CwbhX/uBMS-2/images/Front rev2.PNG

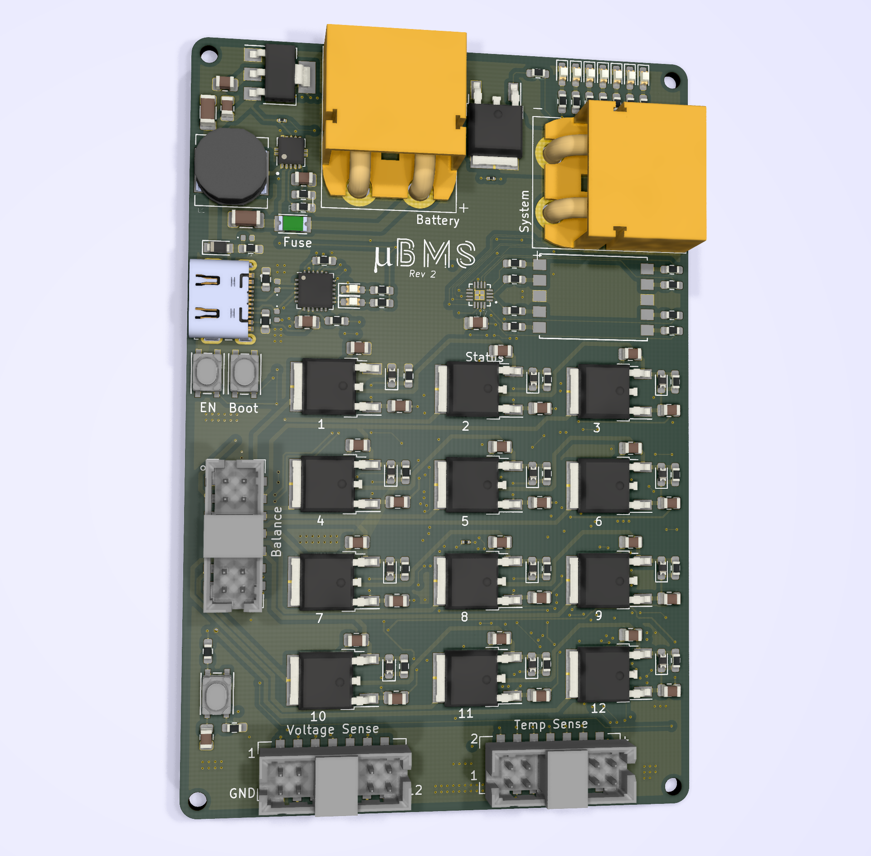
images/Front rev2.PNG
