CwbhX/uBMS-2/images/Back rev2.PNG

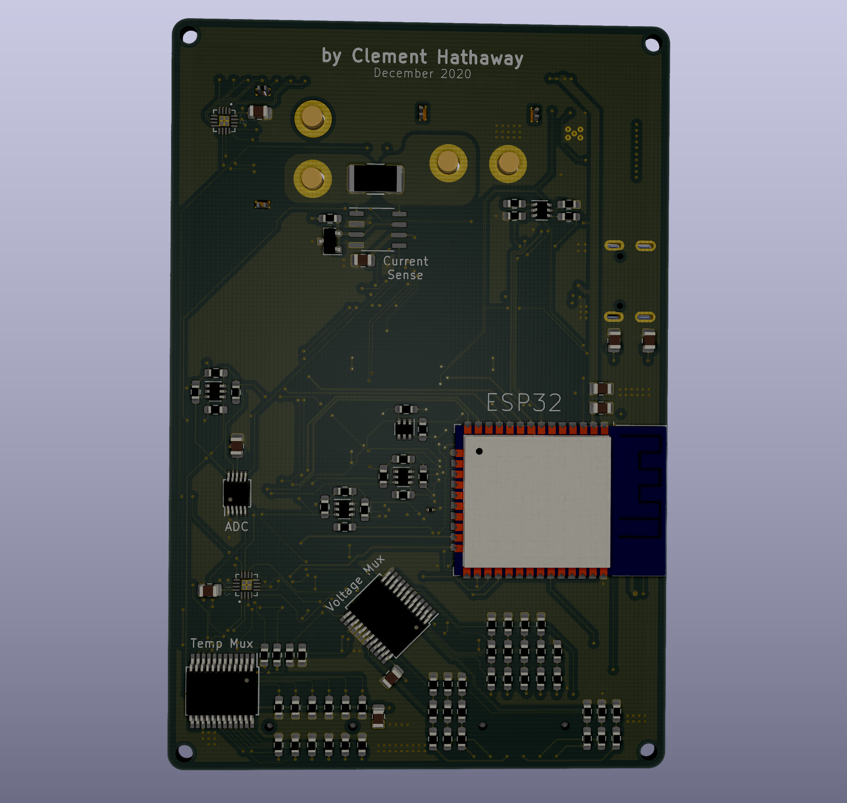
images/Back rev2.PNG
