CwbhX/uBMS-2/documents/Parts List.md

# uBMS Parts List
## Resistors
- Resetable PTC Fuse 300mA: [0ZCF0030FF2C](https://belfuse.com/resources/datasheets/circuitprotection/ds-cp-0zcf-series.pdf)

## Capacitors
- 10nF 50V X7R 0805 Caps: [C0805C103J5RAC7210](https://content.kemet.com/datasheets/KEM_C1002_X7R_SMD.pdf)
- 33nF 50V X7R 0805 Cap: [C0805C333K5RACTU](https://content.kemet.com/datasheets/KEM_C1002_X7R_SMD.pdf)
- 0.1uF 16V Y5V 0805 Caps: [C0805C104Z4VACTU](https://content.kemet.com/datasheets/KEM_C1005_Y5V_SMD.pdf)
- 1uF 16V Y5V 0805 Caps: [C0805C105Z4VACTU](https://content.kemet.com/datasheets/KEM_C1005_Y5V_SMD.pdf)
- 2.2uF 100V X7S 1206 Cin Cap: [HMK316AC7225KL-TE](https://www.yuden.co.jp/productdata/catalog/mlcc06_e.pdf)
- 10uF 10V X5R 0805 Cap: [C0805C106K8PACTU](https://content.kemet.com/datasheets/KEM_C1006_X5R_SMD.pdf)
- 47uF 6.3V X5R 1206 Cout Cap: [JMK316ABJ476MLHT](https://ds.yuden.co.jp/TYCOMPAS/ut/detail?pn=JMK316ABJ476MLHT%20%20&u=M)

## Inductors
- Buck Converter Inductor 100uH: [1267AY-101M=P3](https://www.murata.com/~/media/webrenewal/products/inductor/chip/tokoproducts/wirewoundferritetypeforpl/m_dg8040c.ashx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)

## Diodes
- USB-C Power Input 1A Schottky: [RB162VAM-20TR](https://d1d2qsbl8m0m72.cloudfront.net/en/products/databook/datasheet/discrete/diode/schottky_barrier/rb162vam-20tr-e.pdf)
- USB TVS Protection Diodes: [TPD1E10B06QDPYRQ1](https://www.ti.com/lit/ds/symlink/tpd1e10b06-q1.pdf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)

## Transistors
- 

## Integrated Circuits
- High Voltage Buck Converter 500mA: [LM5166XDRCR](https://www.ti.com/lit/ds/symlink/lm5166.pdf?HQS=TI-null-null-digikeymode-df-pf-null-wwe&ts=1606370714793)
- USB to UART Adapter: [CP2102N-A02-GQFN24](https://www.silabs.com/documents/public/data-sheets/cp2102n-datasheet.pdf)

## Connectors
- Male SMD Batt & Power connector: [XT60PW-M20](https://www.tme.eu/Document/9b8d0c5eb7094295f3d3112c214d3ade/XT60PW%20SPEC.pdf)
- Female USB-C (USB 2.0) Connector: [DX07S016JA1R1500](https://www.jae.com/direct/topics/topics_file_download/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)

## Indicators
- Red UART RX LED: [150060VS55040](https://www.we-online.de/web/en/index.php/download/media/07_electronic_components/download_center_1/application_notes_berichte/ano002_leds___the_future_of_horticultu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)
- Green UART TX LED: [150060SS55040](https://www.we-online.de/web/en/index.php/download/media/07_electronic_components/download_center_1/application_notes_berichte/ano002_leds___the_future_of_horticultu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)
- Yellow LED: [150060YS55040](https://www.we-online.de/web/en/index.php/download/media/07_electronic_components/download_center_1/application_notes_berichte/ano002_leds___the_future_of_horticultu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)
