CwbhX/uBMS-2/3D Models/PLCC6-LED.step

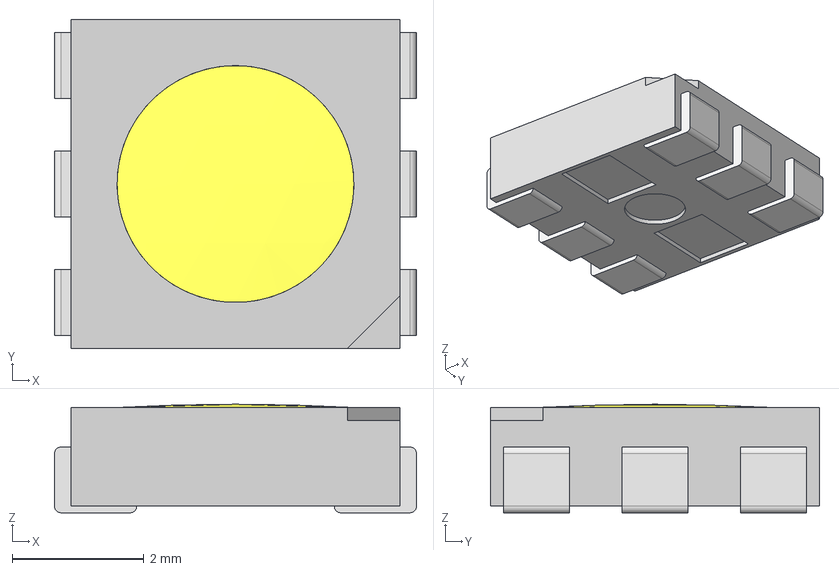
[picture p3: CAD file, 2020-08-05]
3D Models/PLCC6-LED.step
5.50 x 5.00 x 1.65 mm
