CwbhX/uBMS-2/uBMS-2.step

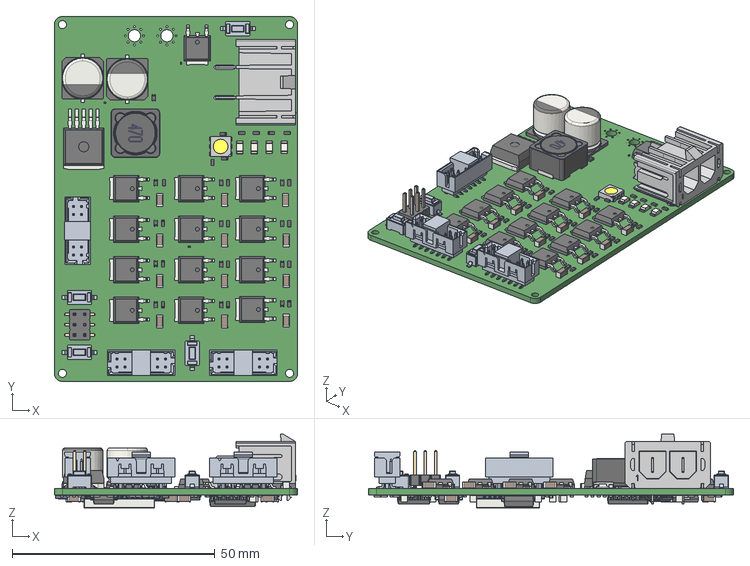
[picture p4: CAD file, 2020-08-12]
uBMS-2.step
60.0 x 90.0 x 18.2 mm
