CwbhX/uBMS-2/3D Models/RES2512.stp

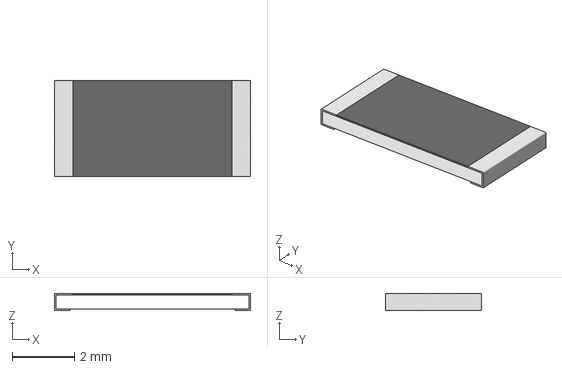
[picture p5: CAD file, 2020-08-05]
3D Models/RES2512.stp
6.30 x 3.10 x 0.55 mm
