CwbhX/uBMS-2/3D Models/SO8 Narrow 3.9mm.step

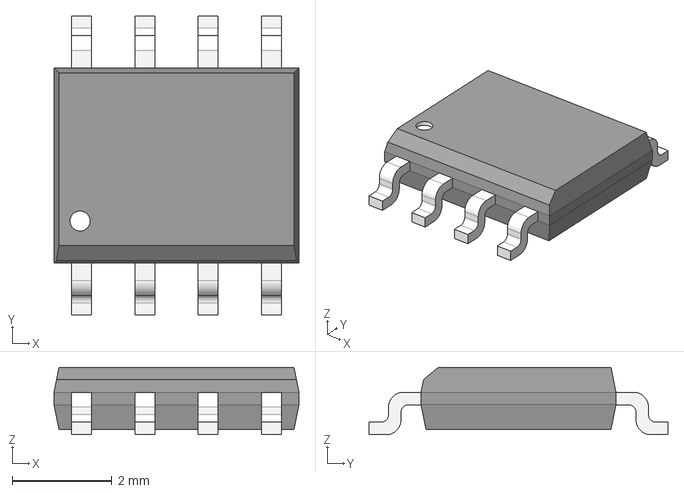
[picture p6: CAD file, 2020-08-05]
3D Models/SO8 Narrow 3.9mm.step
4.90 x 5.98 x 1.35 mm
