CwbhX/uBMS-2/3D Models/Connector_1720430202.step

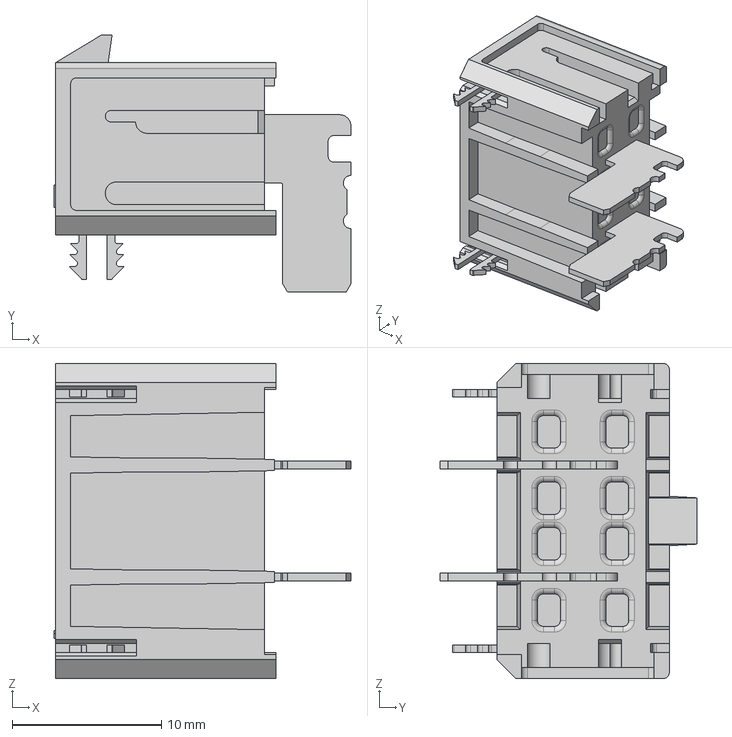
[picture p7: CAD file, 2020-08-05]
3D Models/Connector_1720430202.step
19.9 x 17.2 x 21.1 mm
