CwbhX/uBMS-2/3D Models/DR125 series.stp

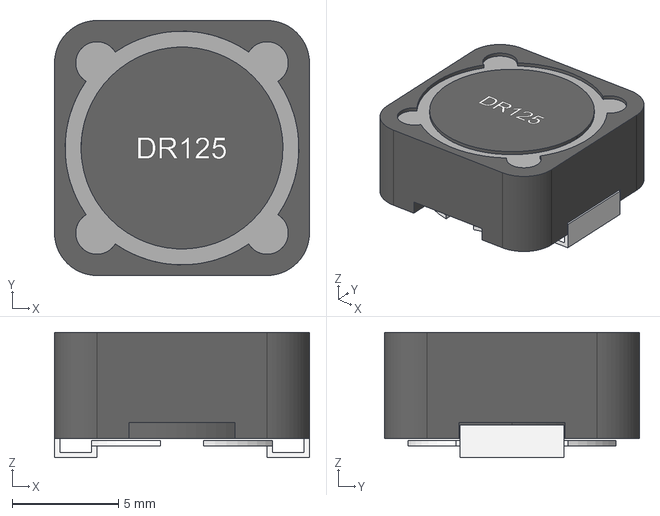
[picture p8: CAD file, 2020-08-05]
3D Models/DR125 series.stp
12.0 x 12.0 x 5.90 mm
