CwbhX/uBMS-2/3D Models/CDRH127_470M.step

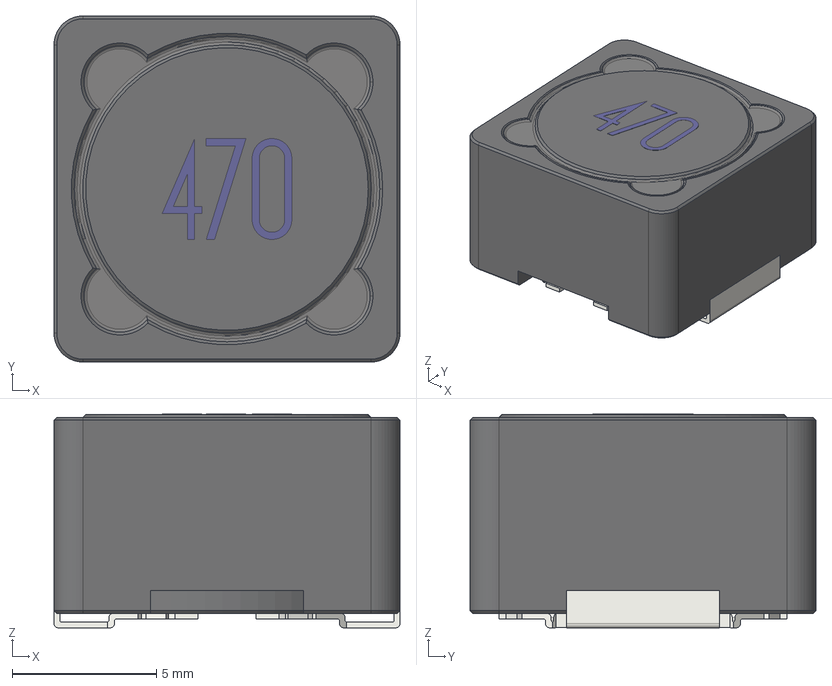
[picture p9: CAD file, 2020-08-05]
3D Models/CDRH127_470M.step
12.0 x 12.0 x 7.41 mm
