CwbhX/uBMS-2/3D Models/PTS636SM43SMTRLFS.stp

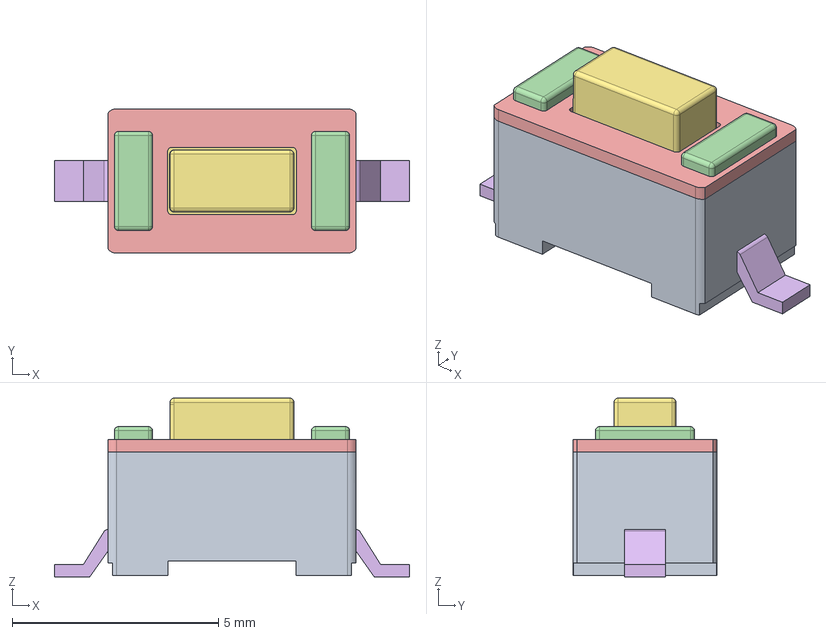
[picture p10: CAD file, 2020-08-05]
3D Models/PTS636SM43SMTRLFS.stp
8.60 x 3.50 x 4.33 mm
