CwbhX/uBMS-2/3D Models/S2B-PH-SM4-TB(LF)(SN)--3DModel-STEP-56544.STEP

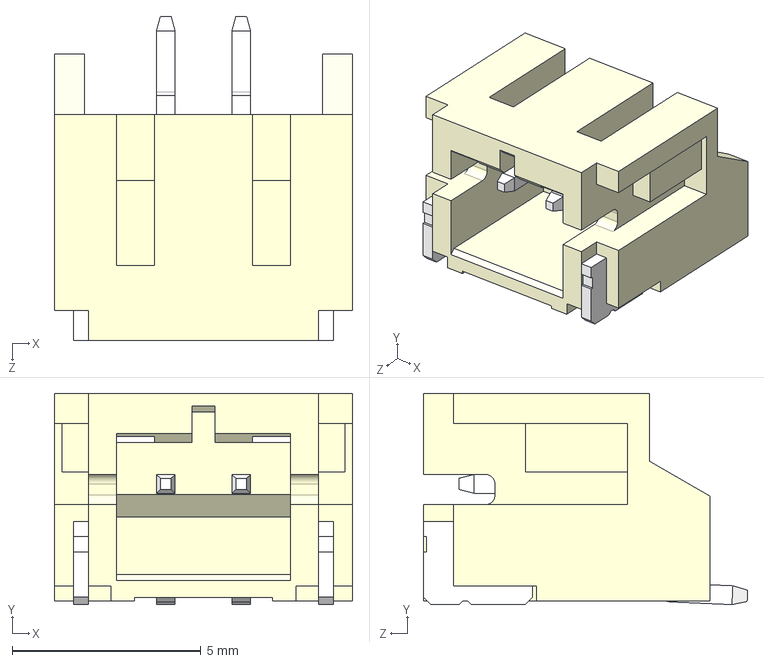
[picture p11: CAD file, 2020-08-03]
3D Models/S2B-PH-SM4-TB(LF)(SN)--3DModel-STEP-56544.STEP
7.90 x 5.60 x 8.60 mm
