CwbhX/uBMS-2/3D Models/878325623.stp

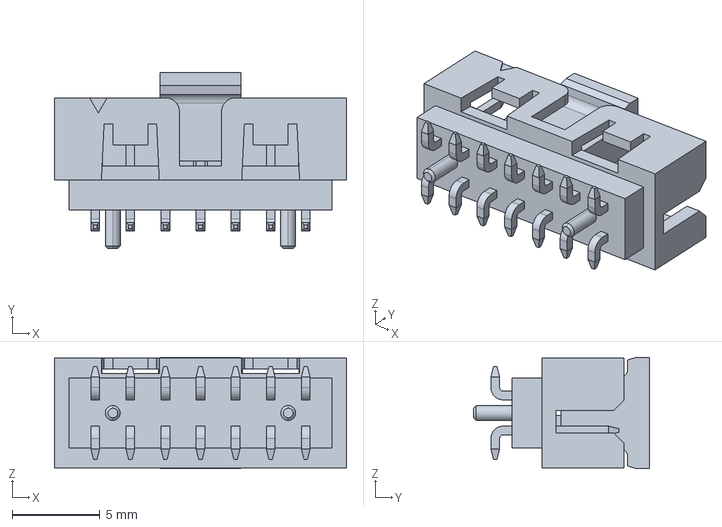
[picture p12: CAD file, 2020-08-05]
3D Models/878325623.stp
16.6 x 10.0 x 6.35 mm
