CwbhX/uBMS-2/(list of files, cad)

Other CAD files:
3D Models/1720430202.stp
