CwbhX/uBMS-2/PDFs/uBMS-2.pdf

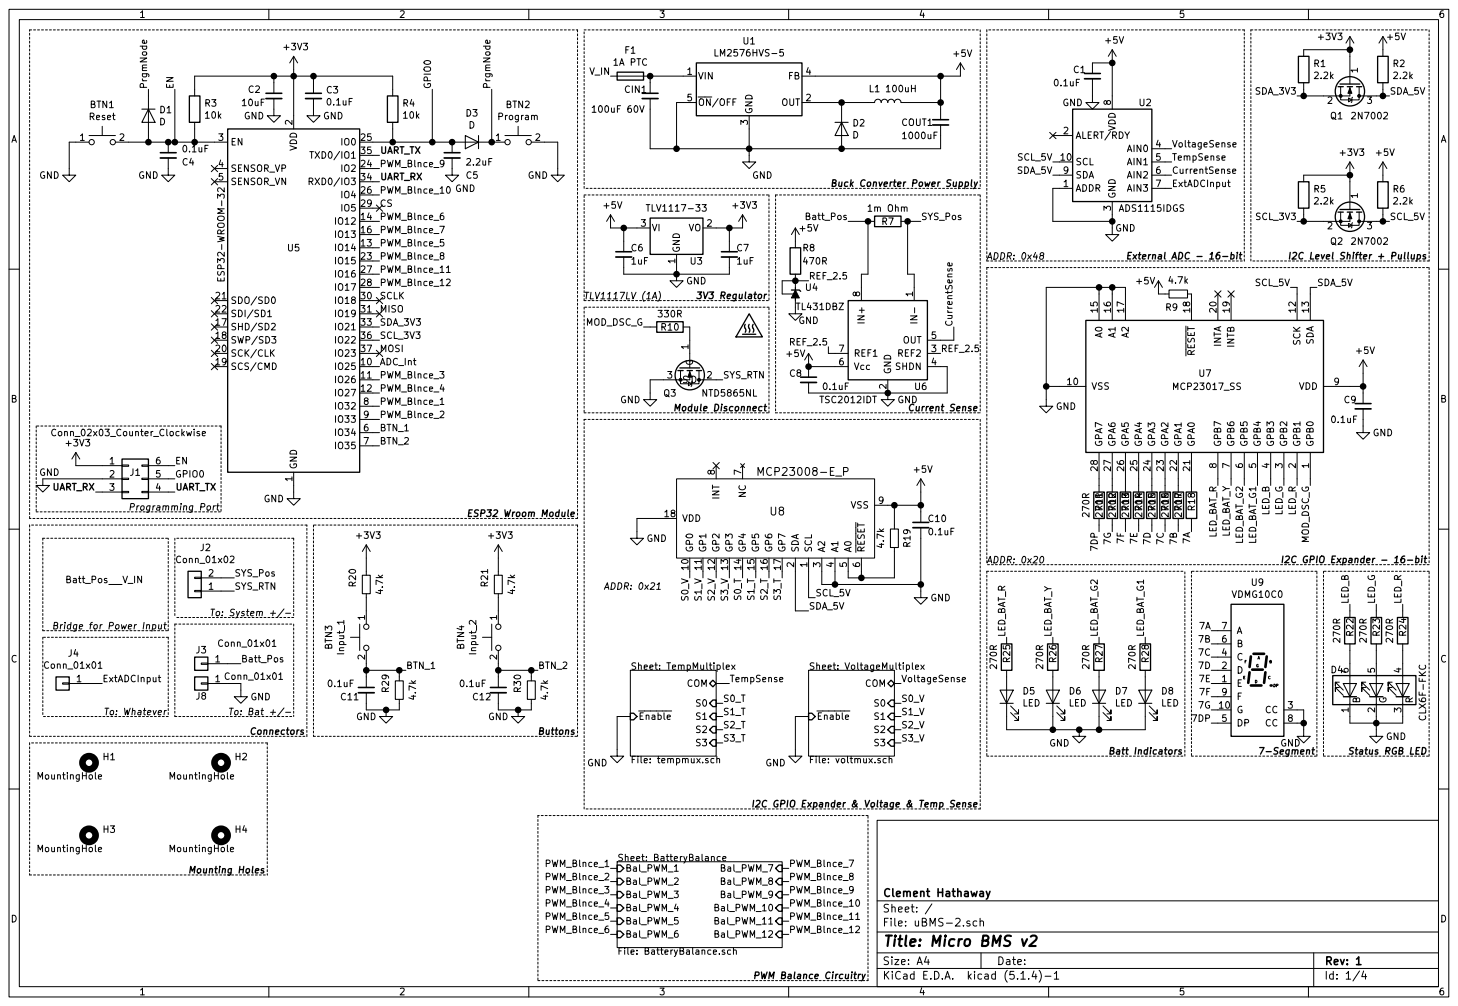
[picture p13: page 1]

2 SCK/CLK 20 SDO/SD0 21 SDI/SD1 22

ADDR: 0x48 Bridge for Power Input

SCLK
I2C GPIO Expander & Voltage & Temp Sense MISO

2 REF2 3 SHDN 4 OUT 5 Vcc 6 REF1 7 IN+

1 VSS 10 SCK 12 SDA 13 A0 15 A1 16 A2 17 RESET 18 INTB 19 GPB1

SCL_5V Module Disconnect Mounting Holes

7-Segment Connectors To: Bat +/-

File: uBMS-2.sch Sheet: / Clement Hathaway

Id: 1/4 Title: Micro BMS v2

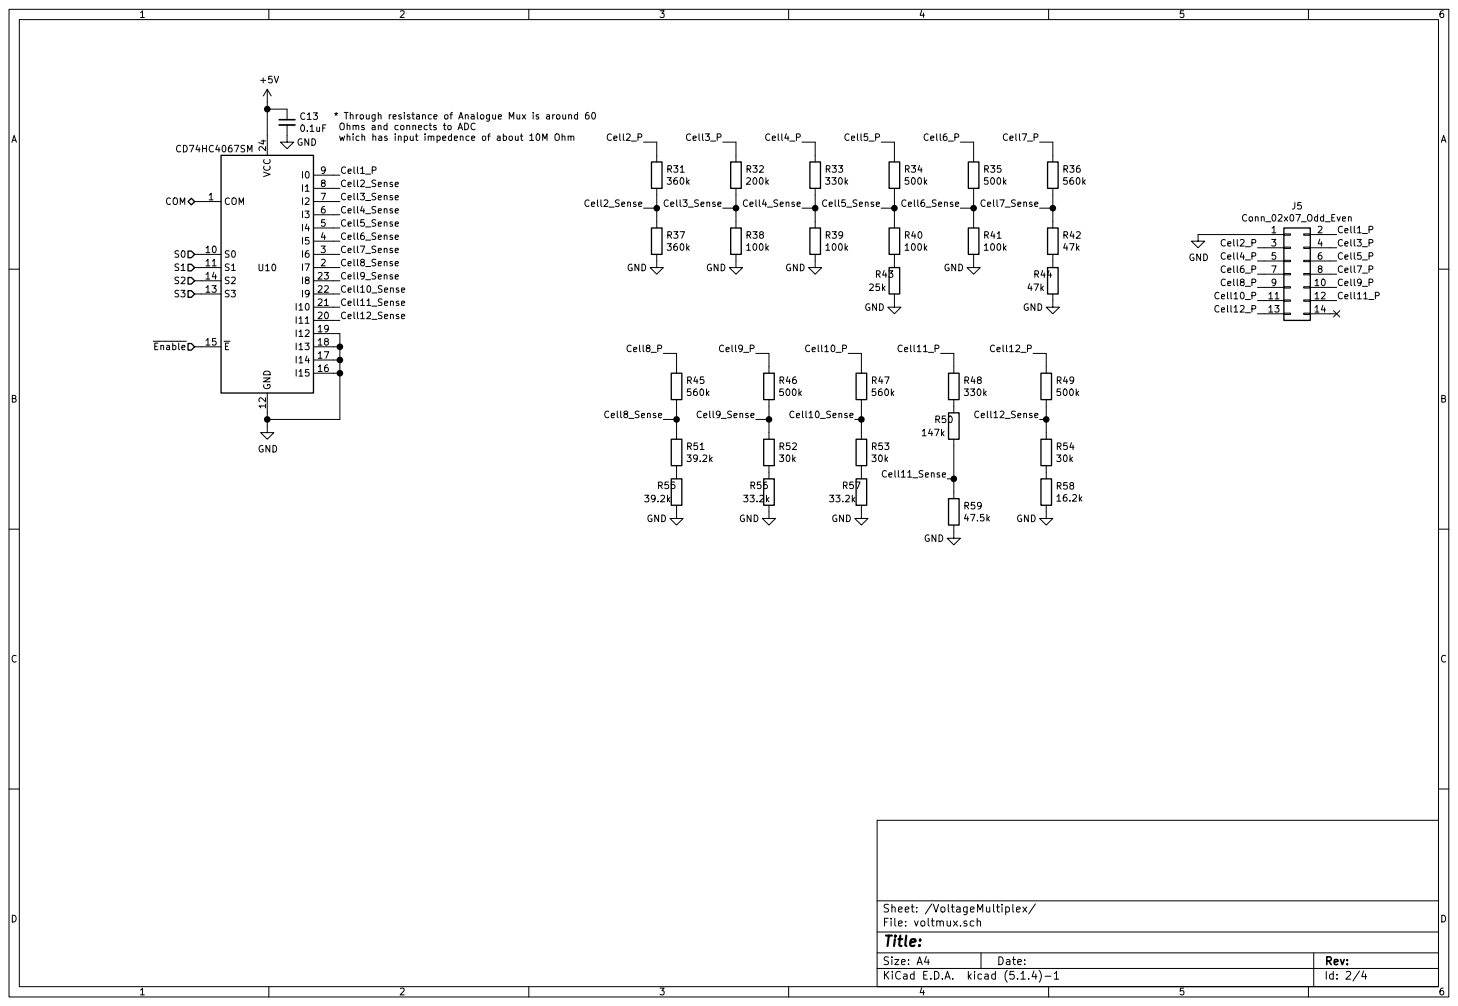
[picture p14: page 2]

* Through resistance of Analogue Mux is around 60
J5 Conn_02x07_Odd_Even C13
0.1uF GND

Ohms and connects to ADC
which has input impedence of about 10M Ohm

Id: 2/4 Title: File: voltmux.sch Sheet: /VoltageMultiplex/

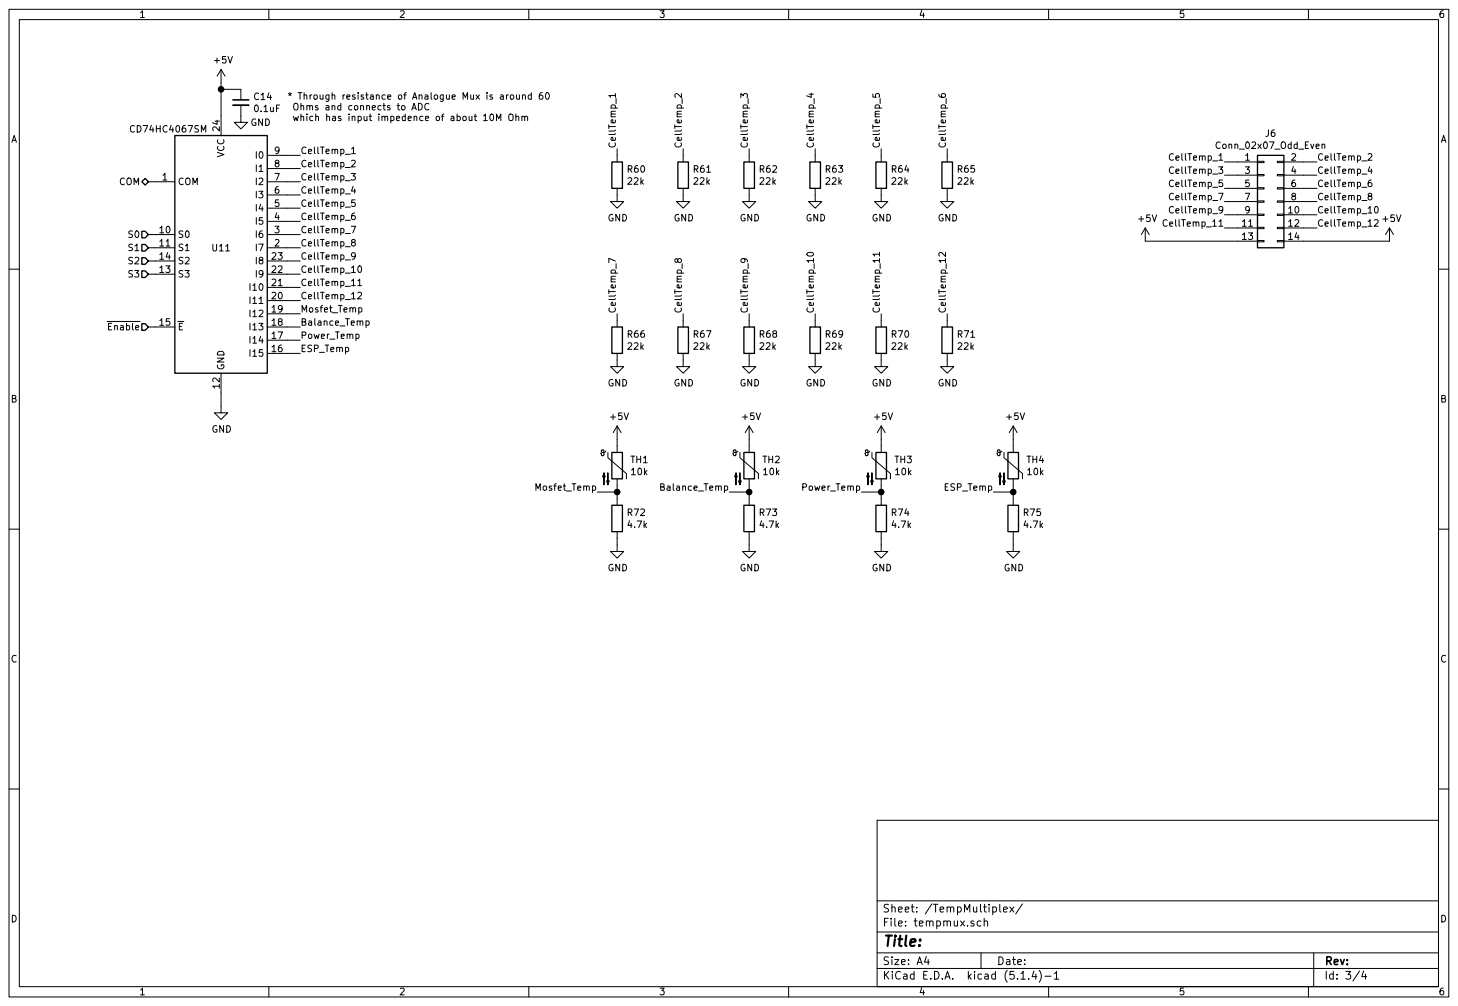
[picture p15: page 3]

* Through resistance of Analogue Mux is around 60

Ohms and connects to ADC
which has input impedence of about 10M Ohm

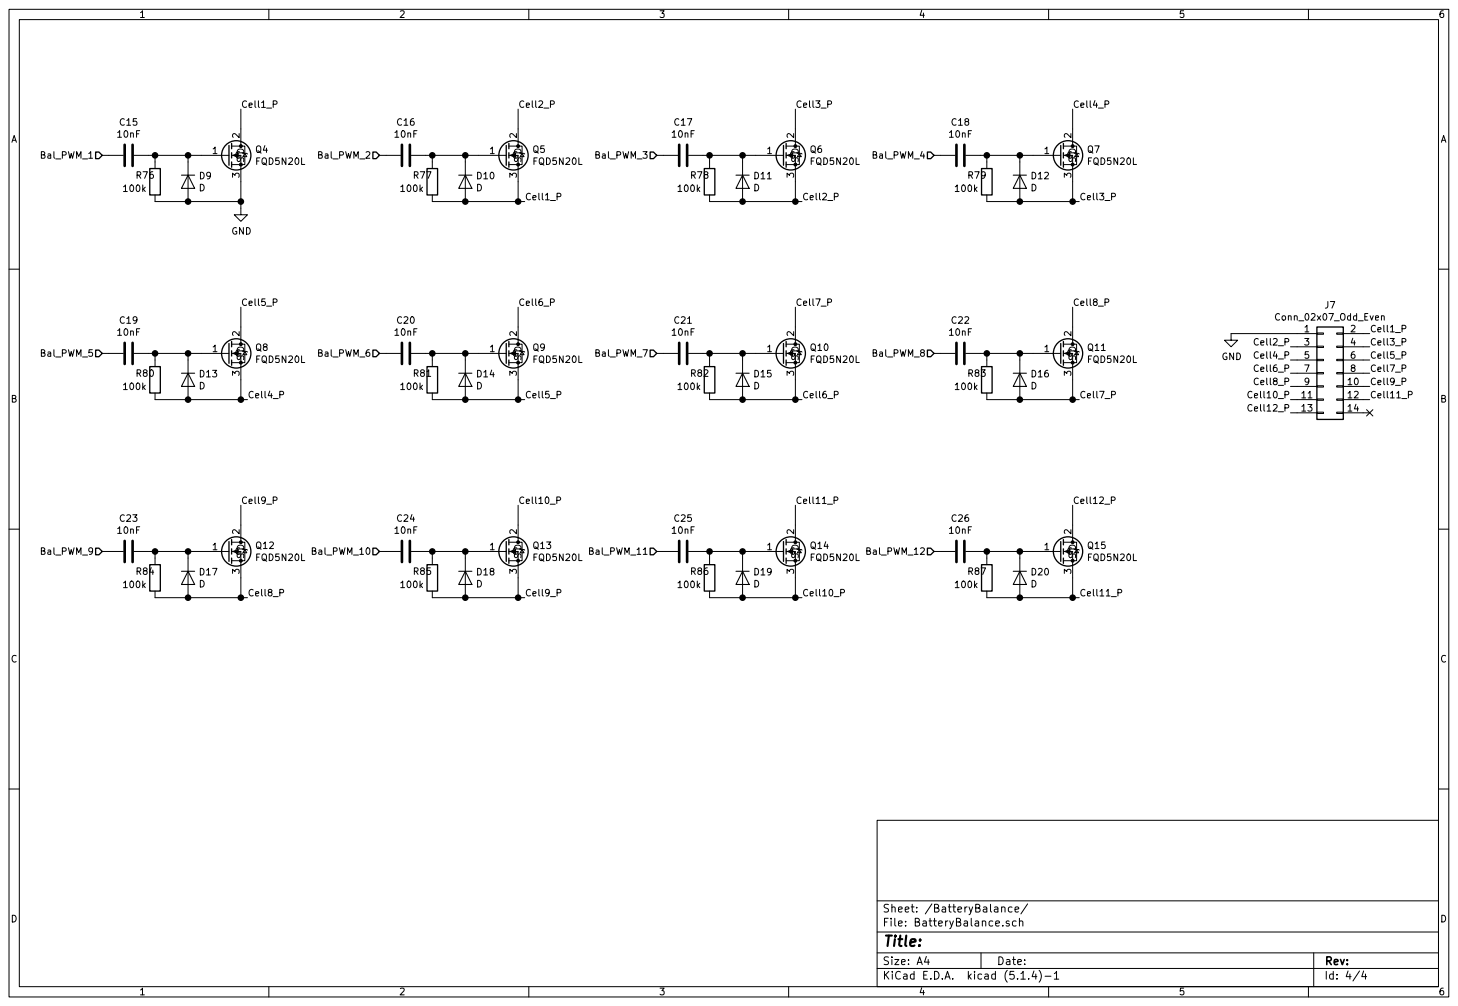
[picture p16: page 4]
