CwbhX/uBMS-2/PDFs/uBMS-2-B_Cu.pdf

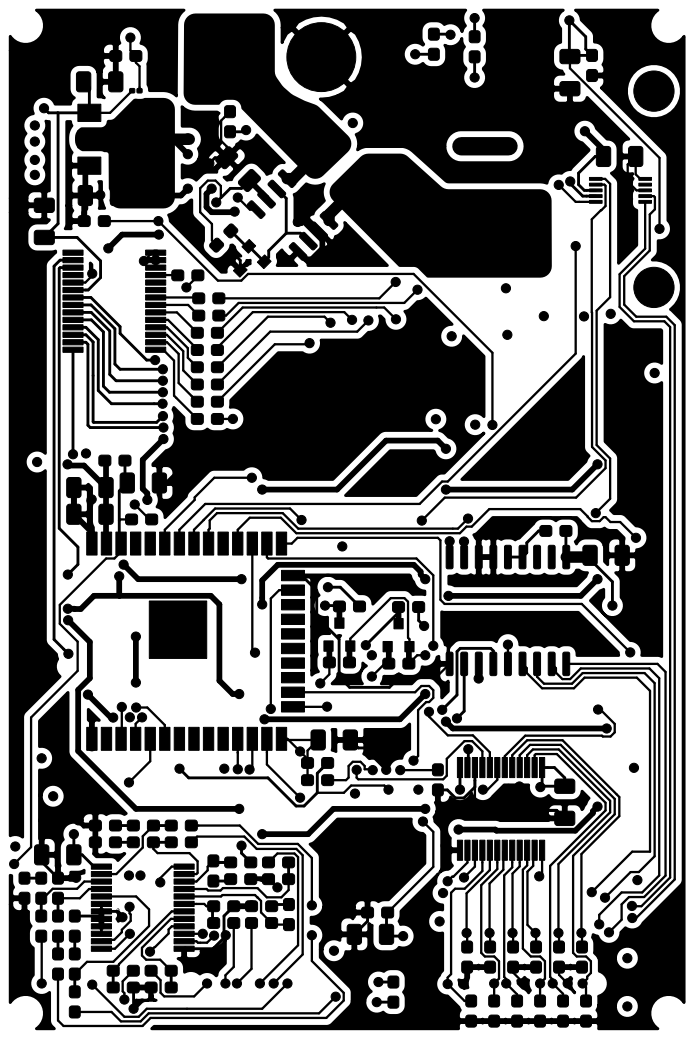
[picture p17: page 1]
