CwbhX/uBMS-2/PDFs/uBMS-2-B_Mask.pdf

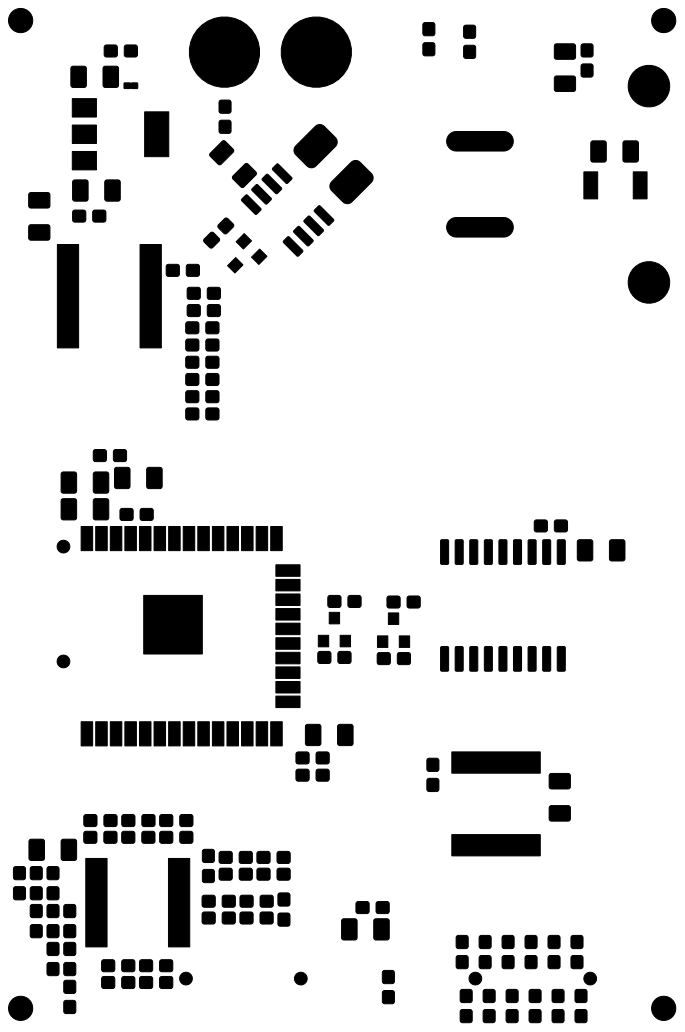
[picture p18: page 1]
