CwbhX/uBMS-2/PDFs/uBMS-2-B_SilkS.pdf

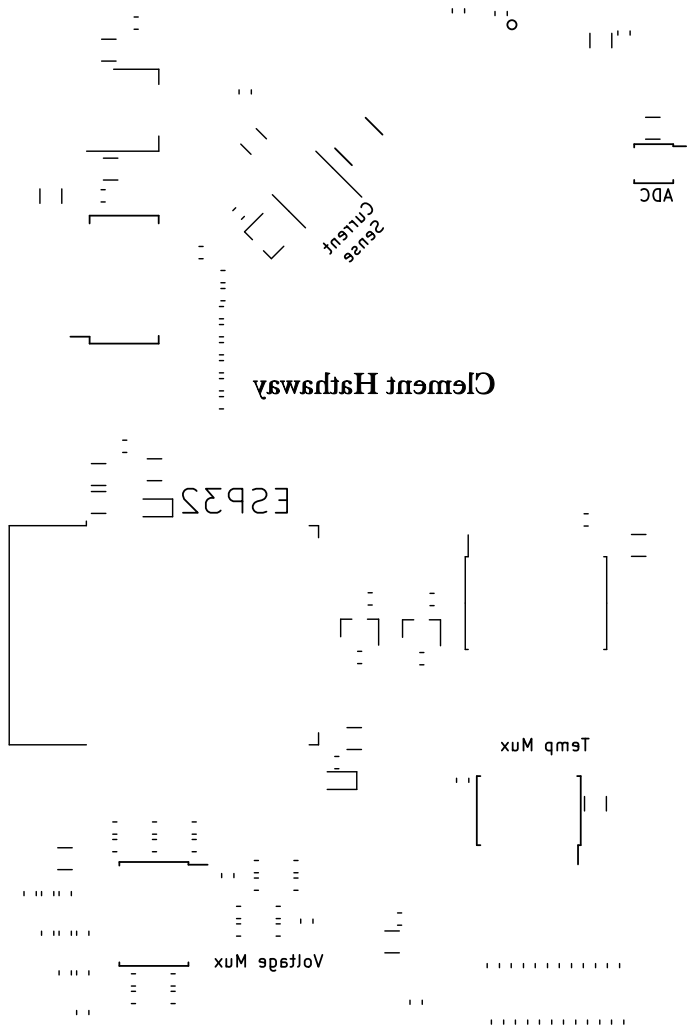
[picture p19: page 1]
