CwbhX/uBMS-2/PDFs/uBMS-2-Edge_Cuts.pdf

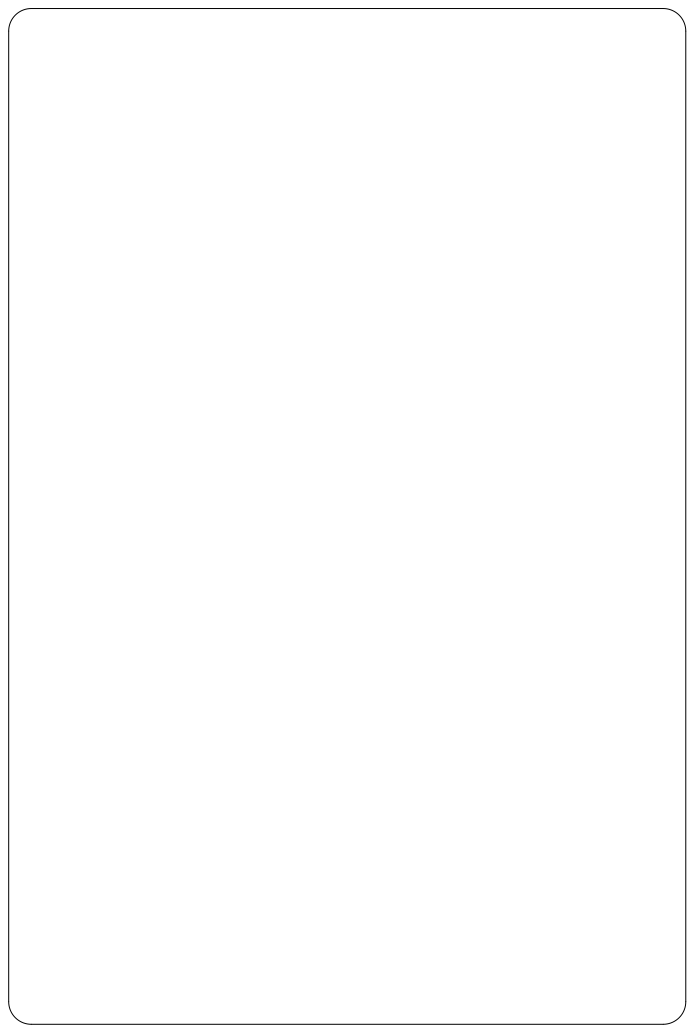
[picture p20: page 1]
