CwbhX/uBMS-2/PDFs/uBMS-2-F_Cu.pdf

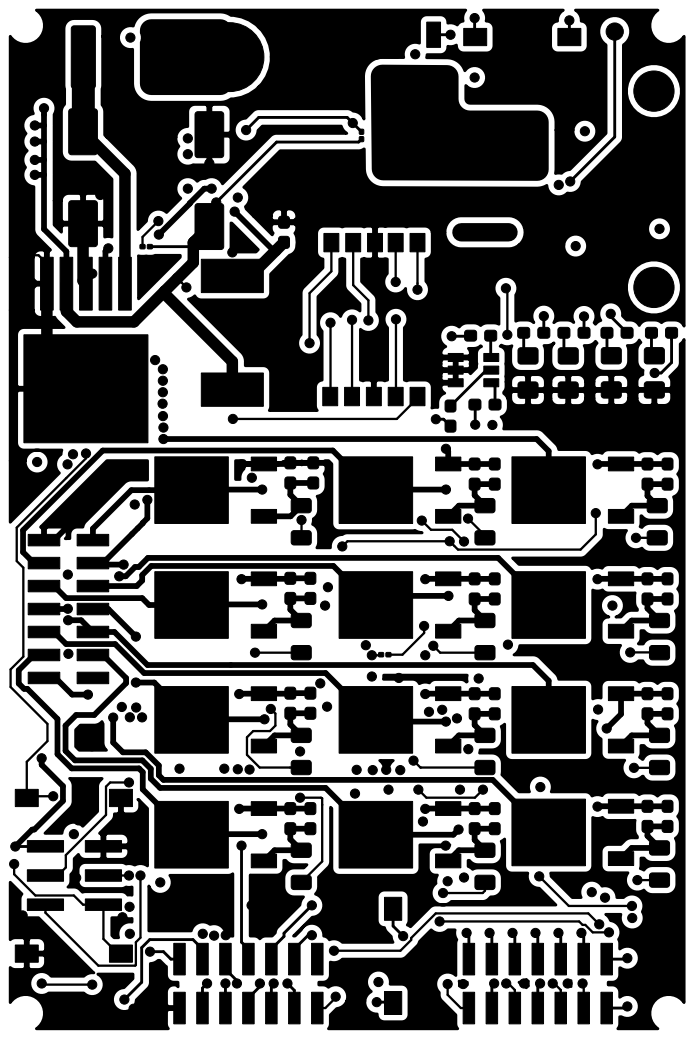
[picture p21: page 1]
