CwbhX/uBMS-2/PDFs/uBMS-2-F_Mask.pdf

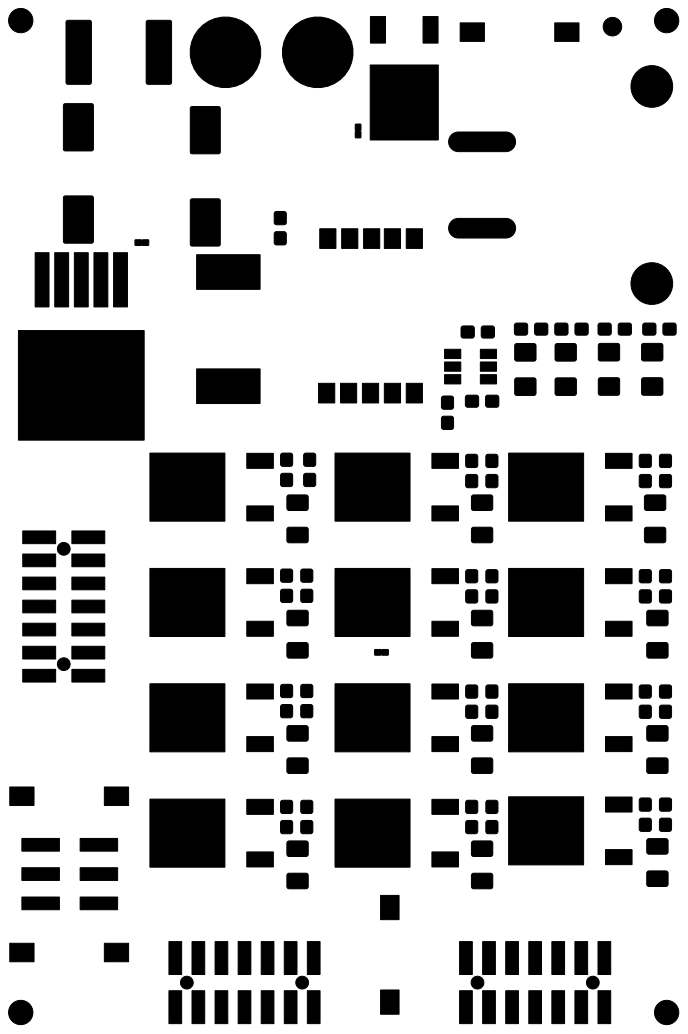
[picture p22: page 1]
