CwbhX/uBMS-2/PDFs/uBMS-2-F_SilkS.pdf

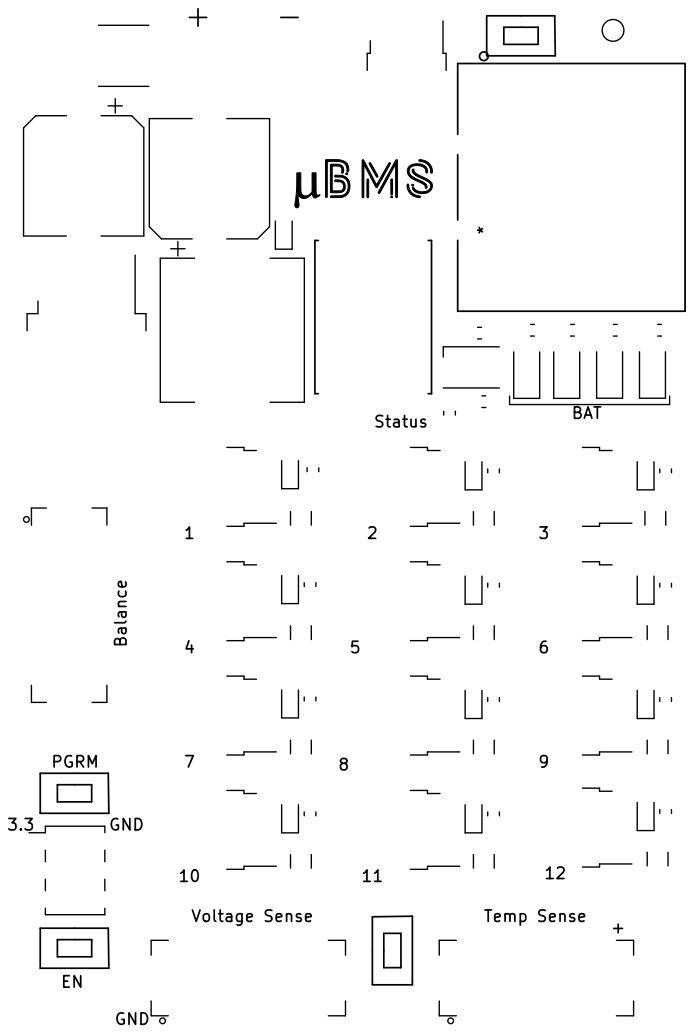
[picture p23: page 1]
