CwbhX/uBMS-2/PDFs/uBMS-2-In1_Cu.pdf

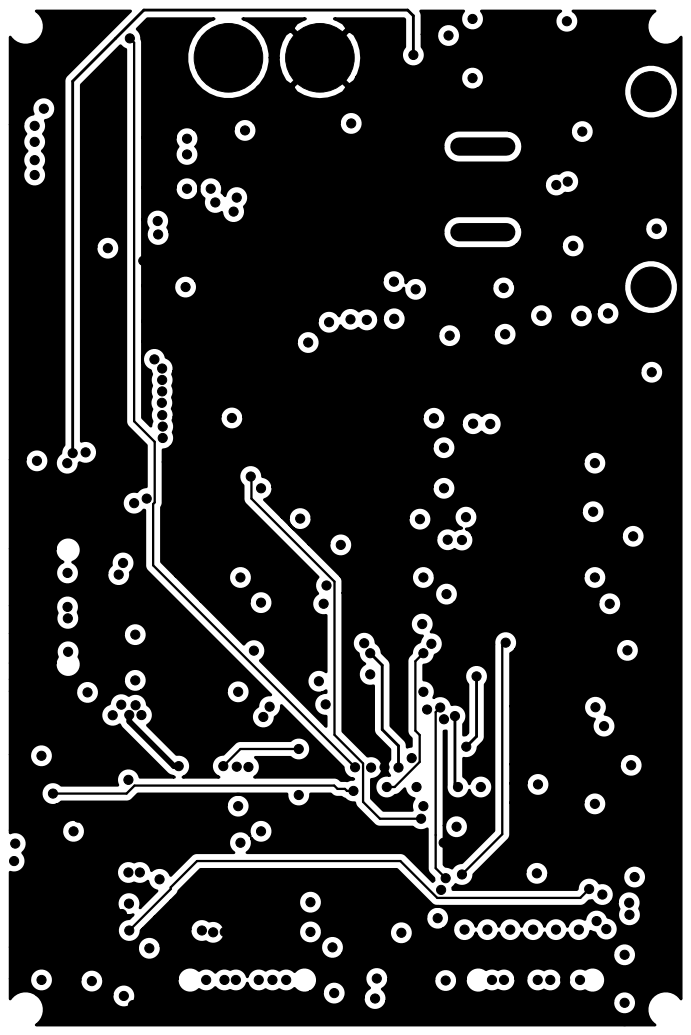
[picture p24: page 1]
