CwbhX/uBMS-2/PDFs/uBMS-2-In2_Cu.pdf

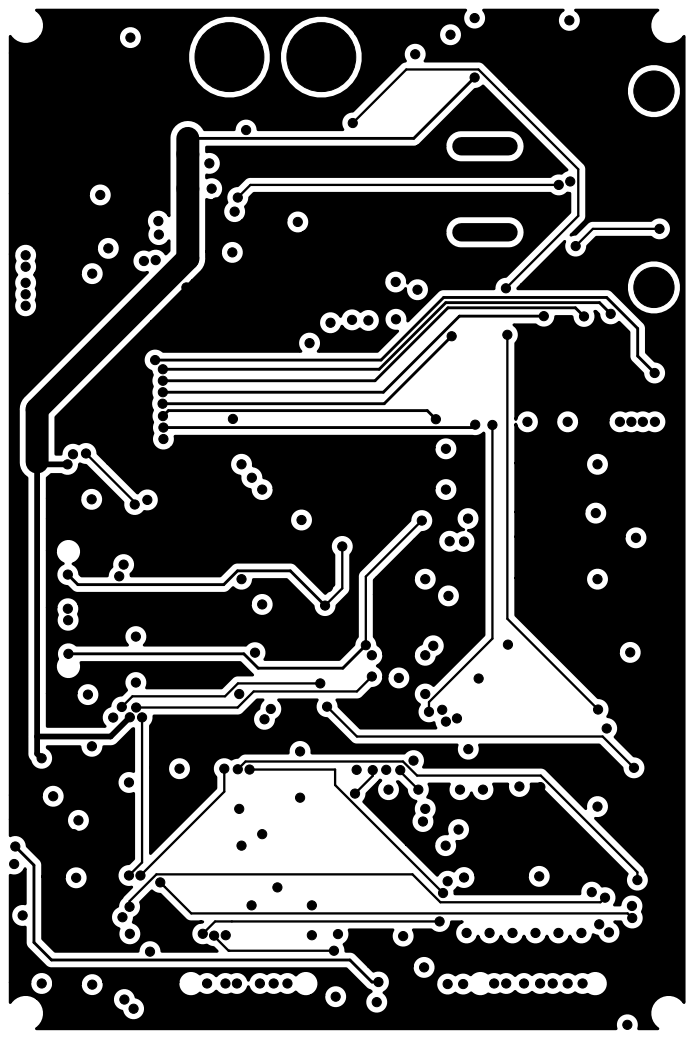
[picture p25: page 1]
