CwbhX/uBMS-2/uBMS-2.kicad_pcb

## KiCad design uBMS-2.kicad_pcb (2022-03-06)

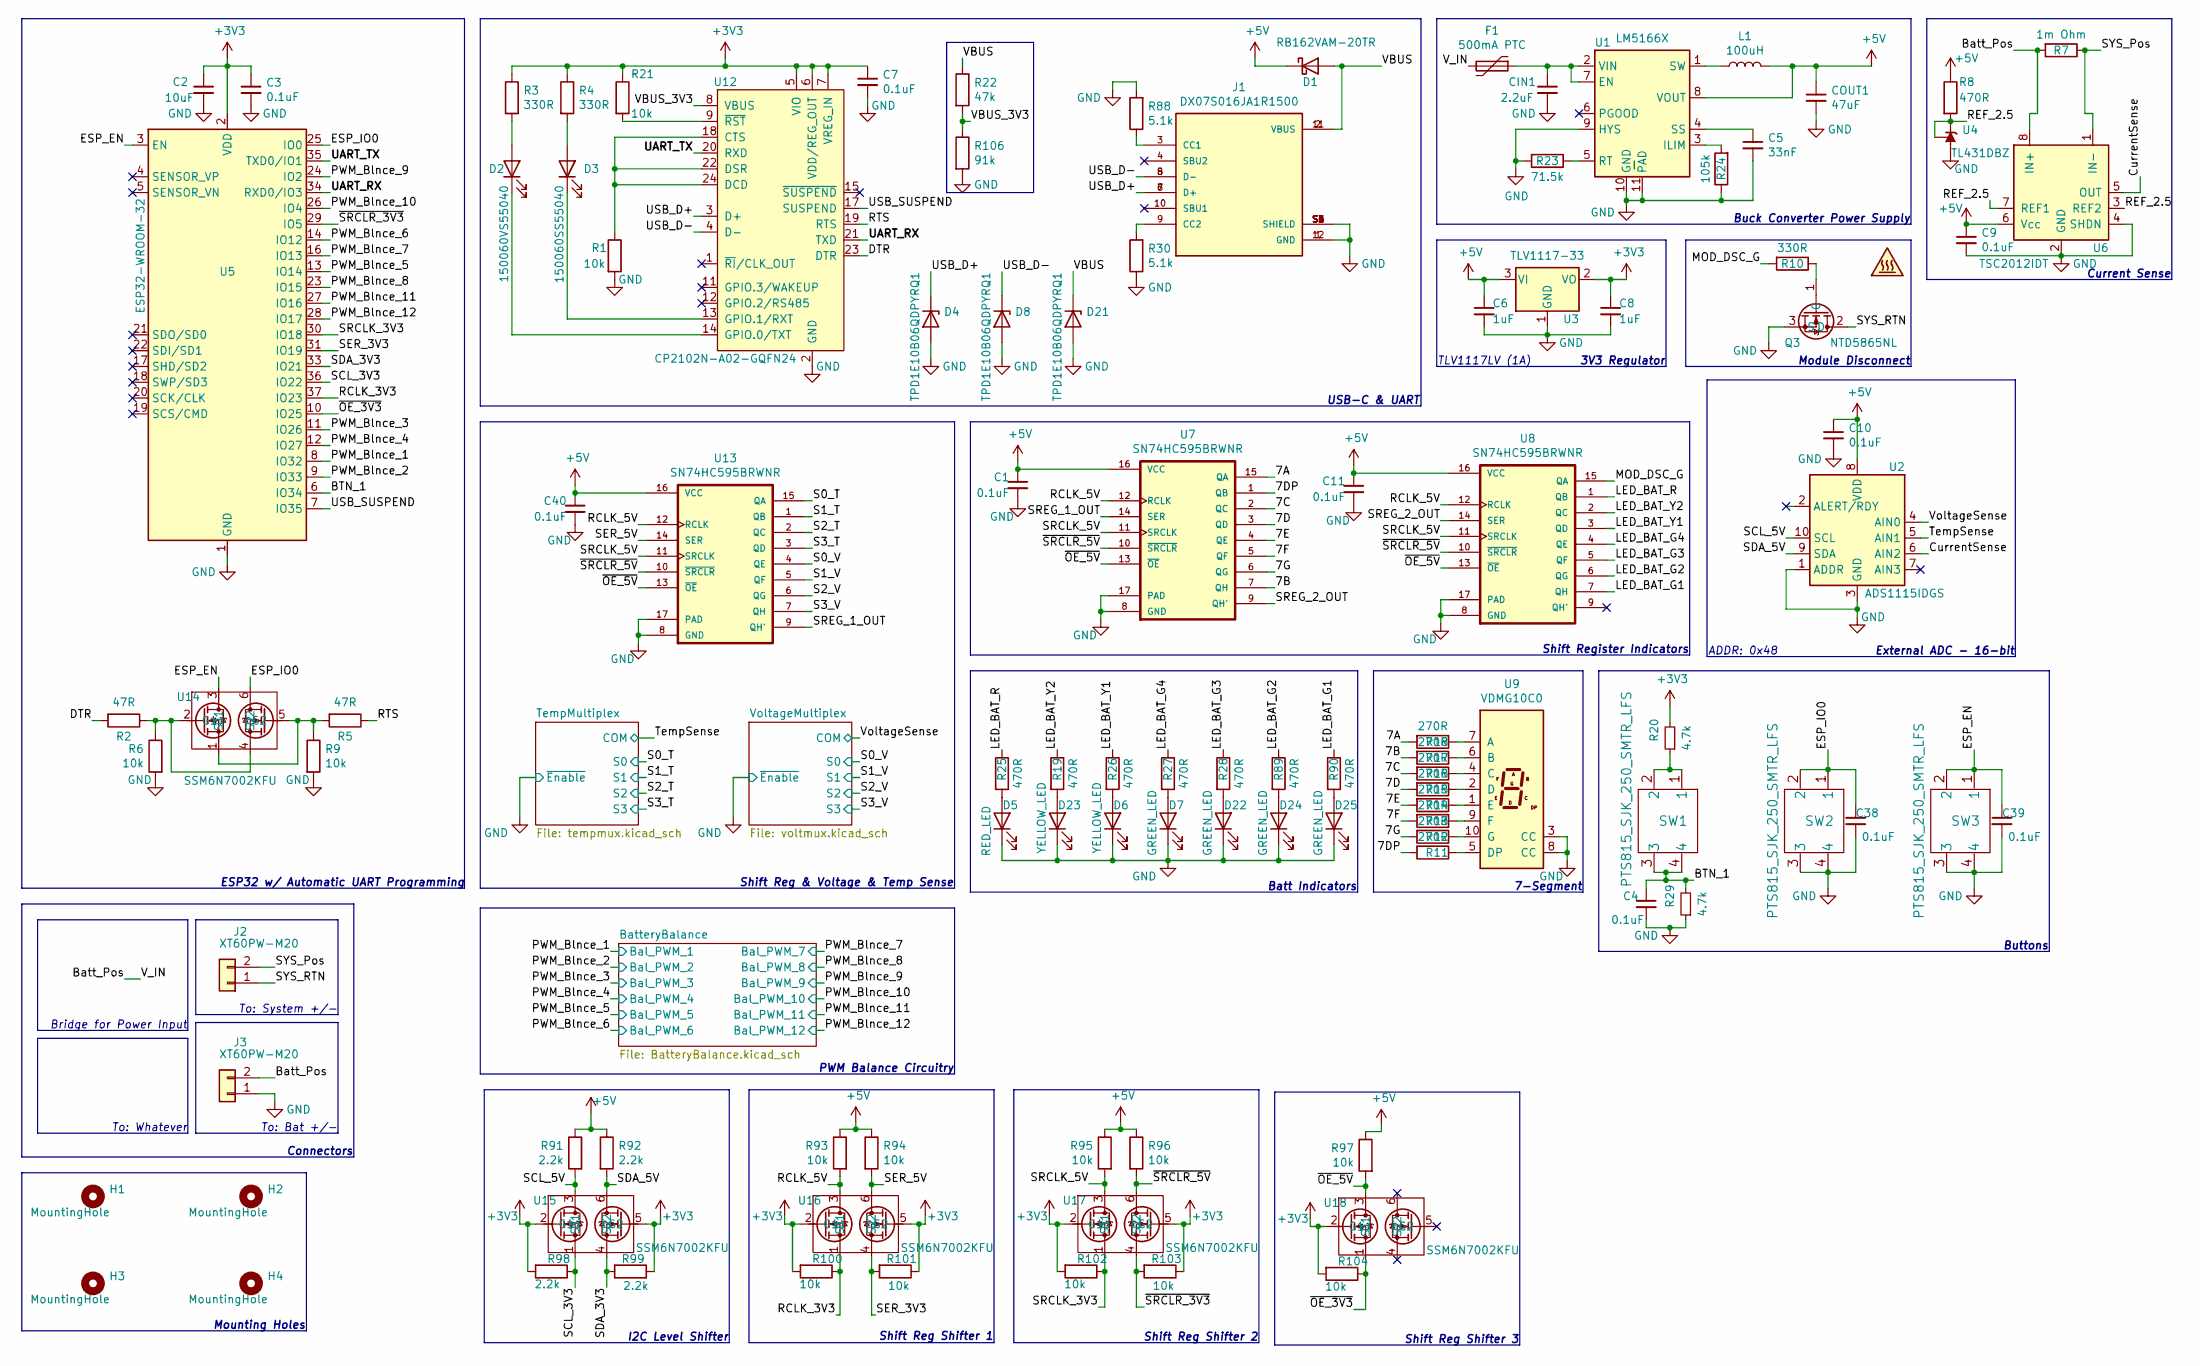
[picture p26: schematic uBMS-2.kicad_sch, Micro BMS v2]

Parts:
C1, C3, C4, C7, C9, C10, C11, C38, C39, C40: 0.1uF; C_0805_2012Metric; Part Number C0805C104Z4VACTU; Digikey Number 399-9159-2-ND
C2: 10uF; C_0805_2012Metric; Part Number C0805C106K8PACTU; Digikey Number 399-4925-2-ND
C5: 33nF; C_0805_2012Metric; Part Number C0805C333K5RACTU; Digikey Number 399-1165-2-ND
C6, C8: 1uF; C_0805_2012Metric; Part Number C0805C105Z4VACTU; Digikey Number 399-8011-2-ND
CIN1: 2.2uF; C_1206_3216Metric; Part Number HMK316AC7225KL-TE; Digikey Number 587-5026-2-ND
COUT1: 47uF; C_1206_3216Metric; Part Number JMK316ABJ476MLHT; Digikey Number 587-3399-2-ND
D1: RB162VAM-20TR; D_TUMD2; Part Number RB162VAM-20TR; Digikey Number RB162VAM-20TRTR-ND
D2: 150060VS55040; LED_0603_1608Metric_Castellated; Part Number 150060VS55040; Digikey Number 732-12017-2-ND
D3: 150060SS55040; LED_0603_1608Metric_Castellated; Part Number 150060SS55040; Digikey Number 732-12016-2-ND
D4, D8, D21: TPD1E10B06QDPYRQ1; D_0402_1005Metric; Part Number TPD1E10B06QDPYRQ1; Digikey Number 296-TPD1E10B06QDPYRQ1TR-ND
D5: RED_LED; LED_0603_1608Metric_Castellated; Part Number 150060SS55040; Digikey Number 732-12016-2-ND
D6, D23: YELLOW_LED; LED_0603_1608Metric_Castellated; Part Number 150060YS55040; Digikey Number 732-12018-2-ND
D7, D22, D24, D25: GREEN_LED; LED_0603_1608Metric_Castellated; Part Number 150060VS55040; Digikey Number 732-12017-2-ND
F1: 500mA PTC; 0ZCJ0050FF2G_3216X125N; Part Number 0ZCJ0050FF2G; Digikey Number 507-1802-2-ND
H1, H2, H3, H4: MountingHole; MountingHole_2mm
J1: DX07S016JA1R1500; PARTREV 1; Digikey Number 670-DX07S016JA1R1500TR-ND
J2, J3: XT60PW-M20
L1: 100uH; 1267AY-101M=P3; Part Number 1267AY-101M=P3; Digikey Number 490-10826-2-ND
Q3: NTD5865NL; TO-252-2; Part Number NTD5865NLT4G; Digikey Number NTD5865NLT4GOSTR-ND
R1, R6, R9, R21, R93, R94, R95, R96, R97, R100, R101, R102, R103, R104: 10k; R_0603_1608Metric_Pad0.98x0.95mm_HandSolder
R2, R5: 47R; R_0603_1608Metric_Pad0.98x0.95mm_HandSolder
R3, R4, R10: 330R; R_0603_1608Metric_Pad0.98x0.95mm_HandSolder
R7: 1m Ohm; R_2512_CSNL2512; Part Number CSNL2512FT1L00; Digikey Number CSNL2512FT1L00TR-ND
R8, R19, R25, R26, R27, R28, R89, R90: 470R; R_0603_1608Metric_Pad0.98x0.95mm_HandSolder
R11, R12, R13, R14, R15, R16, R17, R18: 270R; R_0603_1608Metric_Pad0.98x0.95mm_HandSolder
R20, R29: 4.7k; R_0603_1608Metric_Pad0.98x0.95mm_HandSolder
R22: 47k; R_0603_1608Metric_Pad0.98x0.95mm_HandSolder
R23: 71.5k; R_0603_1608Metric_Pad0.98x0.95mm_HandSolder
R24: 105k; R_0603_1608Metric_Pad0.98x0.95mm_HandSolder
R30, R88: 5.1k; R_0603_1608Metric_Pad0.98x0.95mm_HandSolder
R91, R92, R98, R99: 2.2k; R_0603_1608Metric_Pad0.98x0.95mm_HandSolder
R106: 91k; R_0603_1608Metric_Pad0.98x0.95mm_HandSolder
SW1, SW2, SW3: PTS815_SJK_250_SMTR_LFS; Part Number PTS815_SJK_250_SMTR_LFS; Digikey Number CKN12216-2-ND
U1: LM5166X; Texas_S-PVSON-N10_ThermalVias; Part Number LM5166XDRCR; Digikey Number 296-47662-2-ND
U2: ADS1115IDGS; TSSOP-10_3x3mm_P0.5mm; Part Number ADS1115IDGSR; Digikey Number 296-38849-2-ND
U3: TLV1117-33; SOT-223-3_TabPin2; Part Number TLV1117LV33DCYR; Digikey Number 296-28778-2-ND
U4: TL431DBZ; SOT-23; Part Number TL431ACDBZR
U5: ESP32-WROOM-32
U6: TSC2012IDT; SO-8_3.9x4.9mm_P1.27mm; Part Number TSC2012IDT; Digikey Number 497-TSC2012IDTTR-ND
U7, U8: SN74HC595BRWNR; QFN40P250X250X50-17N
U9: VDMG10C0; Part Number VDMG10C0; Digikey Number VDMG10C0TR-ND
U12: CP2102N-A02-GQFN24; QFN-24-1EP_4x4mm_P0.5mm_EP2.6x2.6mm; Part Number CP2102N-A02-GQFN24; Digikey Number 336-5887-ND
U13: SN74HC595BRWNR; QFN40P250X250X50-17N; Part Number SN74HC595BRWNR; Digikey Number 296-44070-2-ND
U14, U15, U16, U17, U18: SSM6N7002KFU; SOT-363_SC-70-6; Part Number SSM6N7002KFU; Digikey Number SSM6N7002KFULFTR-ND

Connections:
/7A: R18.2, U7.15 (QA)
/7B: R17.2, U7.7 (QH)
/7C: R16.2, U7.2 (QC)
/7D: R15.2, U7.3 (QD)
/7DP: R11.2, U7.1 (QB)
/7E: R14.2, U7.4 (QE)
/7F: R13.2, U7.5 (QF)
/7G: R12.2, U7.6 (QG)
/BTN_1: C4.1, R29.2, SW1.3, SW1.4, U5.6 (IO34)
/Batt_Pos: F1.2, J3.2, R7.2, U6.8 (IN+)
/CurrentSense: U2.6 (AIN2), U6.5 (OUT)
/DTR: R2.2, U12.23 (DTR)
/ESP_EN: C39.1, SW3.1, SW3.2, U5.3 (EN), U14.3 (D1)
/ESP_IO0: C38.1, SW2.1, SW2.2, U5.25 (IO0), U14.6 (D2)
/LED_BAT_G1: R90.1, U8.7 (QH)
/LED_BAT_G2: R89.1, U8.6 (QG)
/LED_BAT_G3: R28.1, U8.5 (QF)
/LED_BAT_G4: R27.1, U8.4 (QE)
/LED_BAT_R: R25.1, U8.1 (QB)
/LED_BAT_Y1: R26.1, U8.3 (QD)
/LED_BAT_Y2: R19.1, U8.2 (QC)
/MOD_DSC_G: R10.2, U8.15 (QA)
/PWM_Blnce_1: U5.8 (IO32); also elsewhere on the board
/PWM_Blnce_2: U5.9 (IO33); also elsewhere on the board
/PWM_Blnce_3: U5.11 (IO26); also elsewhere on the board
/PWM_Blnce_4: U5.12 (IO27); also elsewhere on the board
/PWM_Blnce_5: U5.13 (IO14); also elsewhere on the board
/PWM_Blnce_6: U5.14 (IO12); also elsewhere on the board
/PWM_Blnce_7: U5.16 (IO13); also elsewhere on the board
/PWM_Blnce_8: U5.23 (IO15); also elsewhere on the board
/PWM_Blnce_9: U5.24 (IO2); also elsewhere on the board
/PWM_Blnce_10: U5.26 (IO4); also elsewhere on the board
/PWM_Blnce_11: U5.27 (IO16); also elsewhere on the board
/PWM_Blnce_12: U5.28 (IO17); also elsewhere on the board
/RCLK_3V3: R100.1, U5.37 (IO23), U16.1 (S1)
/RCLK_5V: R93.2, U7.12 (RCLK), U8.12 (RCLK), U13.12 (RCLK), U16.3 (D1)
/REF_2.5: R8.2, U4.1 (K), U4.2 (REF), U6.3 (REF2), U6.7 (REF1)
/RTS: R5.1, U12.19 (RTS)
/S0_T: U13.15 (QA); also elsewhere on the board
/S0_V: U13.4 (QE); also elsewhere on the board
/S1_T: U13.1 (QB); also elsewhere on the board
/S1_V: U13.5 (QF); also elsewhere on the board
/S2_T: U13.2 (QC); also elsewhere on the board
/S2_V: U13.6 (QG); also elsewhere on the board
/S3_T: U13.3 (QD); also elsewhere on the board
/S3_V: U13.7 (QH); also elsewhere on the board
/SCL_3V3: R98.1, U5.36 (IO22), U15.1 (S1)
/SCL_5V: R91.2, U2.10 (SCL), U15.3 (D1)
/SDA_3V3: R99.2, U5.33 (IO21), U15.4 (S2)
/SDA_5V: R92.2, U2.9 (SDA), U15.6 (D2)
/SER_3V3: R101.2, U5.31 (IO19), U16.4 (S2)
/SER_5V: R94.2, U13.14 (SER), U16.6 (D2)
/SRCLK_3V3: R102.1, U5.30 (IO18), U17.1 (S1)
/SRCLK_5V: R95.2, U7.11 (SRCLK), U8.11 (SRCLK), U13.11 (SRCLK), U17.3 (D1)
/SREG_1_OUT: U7.14 (SER), U13.9 (QH')
/SREG_2_OUT: U7.9 (QH'), U8.14 (SER)
/SYS_Pos: J2.2, R7.1, U6.1 (IN-)
/SYS_RTN: J2.1, Q3.2 (D)
/TempSense: U2.5 (AIN1); also elsewhere on the board
/UART_RX: U5.34 (RXD0/IO3), U12.21 (TXD)
/UART_TX: U5.35 (TXD0/IO1), U12.20 (RXD)
/USB_D+: D4.1 (K), J1.6 (D+), J1.7 (D+), U12.3 (D+)
/USB_D-: D8.1 (K), J1.5 (D-), J1.8 (D-), U12.4 (D-)
/USB_SUSPEND: U5.7 (IO35), U12.17 (SUSPEND)
/VoltageSense: U2.4 (AIN0); also elsewhere on the board
/~OE_3V3: R104.1, U5.10 (IO25), U18.1 (S1)
/~OE_5V: R97.2, U7.13 (~OE), U8.13 (~OE), U13.13 (~OE), U18.3 (D1)
/~SRCLR_3V3: R103.2, U5.29 (IO5), U17.4 (S2)
/~SRCLR_5V: R96.2, U7.10 (~SRCLR), U8.10 (~SRCLR), U13.10 (~SRCLR), U17.6 (D2)
unnamed: C5.1, U1.4 (SS)
unnamed: CIN1.1, F1.1, U1.2 (VIN), U1.7 (EN)
unnamed: D2.1 (K), U12.14 (GPIO.0/TXT)
unnamed: D2.2 (A), R3.2
unnamed: D3.1 (K), U12.13 (GPIO.1/RXT)
unnamed: D3.2 (A), R4.2
unnamed: D5.2 (A), R25.2
unnamed: D6.2 (A), R26.2
unnamed: D7.2 (A), R27.2
unnamed: D22.2 (A), R28.2
unnamed: D23.2 (A), R19.2
unnamed: D24.2 (A), R89.2
unnamed: D25.2 (A), R90.2
unnamed: J1.3 (CC1), R88.1
unnamed: J1.9 (CC2), R30.2
unnamed: L1.1, U1.1 (SW)
unnamed: Q3.1 (G), R10.1
unnamed: R1.1, U12.18 (CTS), U12.22 (DSR), U12.24 (DCD)
unnamed: R2.1, R6.1, U14.2 (G1), U14.4 (S2)
unnamed: R5.2, R9.1, U14.1 (S1), U14.5 (G2)
unnamed: R11.1, U9.5 (DP)
unnamed: R12.1, U9.10 (G)
unnamed: R13.1, U9.9 (F)
unnamed: R14.1, U9.1 (E)
unnamed: R15.1, U9.2 (D)
unnamed: R16.1, U9.4 (C)
unnamed: R17.1, U9.6 (B)
unnamed: R18.1, U9.7 (A)
unnamed: R20.1, SW1.1, SW1.2
unnamed: R21.2, U12.9 (~RST)
unnamed: R23.1, U1.5 (RT)
unnamed: R24.2, U1.3 (ILIM)

Notes on the sheet:
To: System +/-
ESP32 w/ Automatic UART Programming
Shift Reg & Voltage & Temp Sense
Mounting Holes
Shift Reg Shifter 3
Module Disconnect
Shift Register Indicators
To: Whatever
Shift Reg Shifter 1
3V3 Regulator
Buttons
I2C Level Shifter
Connectors
Batt Indicators
To: Bat +/-
PWM Balance Circuitry
ADDR: 0x48
TLV1117LV (1A)
Buck Converter Power Supply
Shift Reg Shifter 2
USB-C & UART
7-Segment
External ADC - 16-bit
Bridge for Power Input
Current Sense

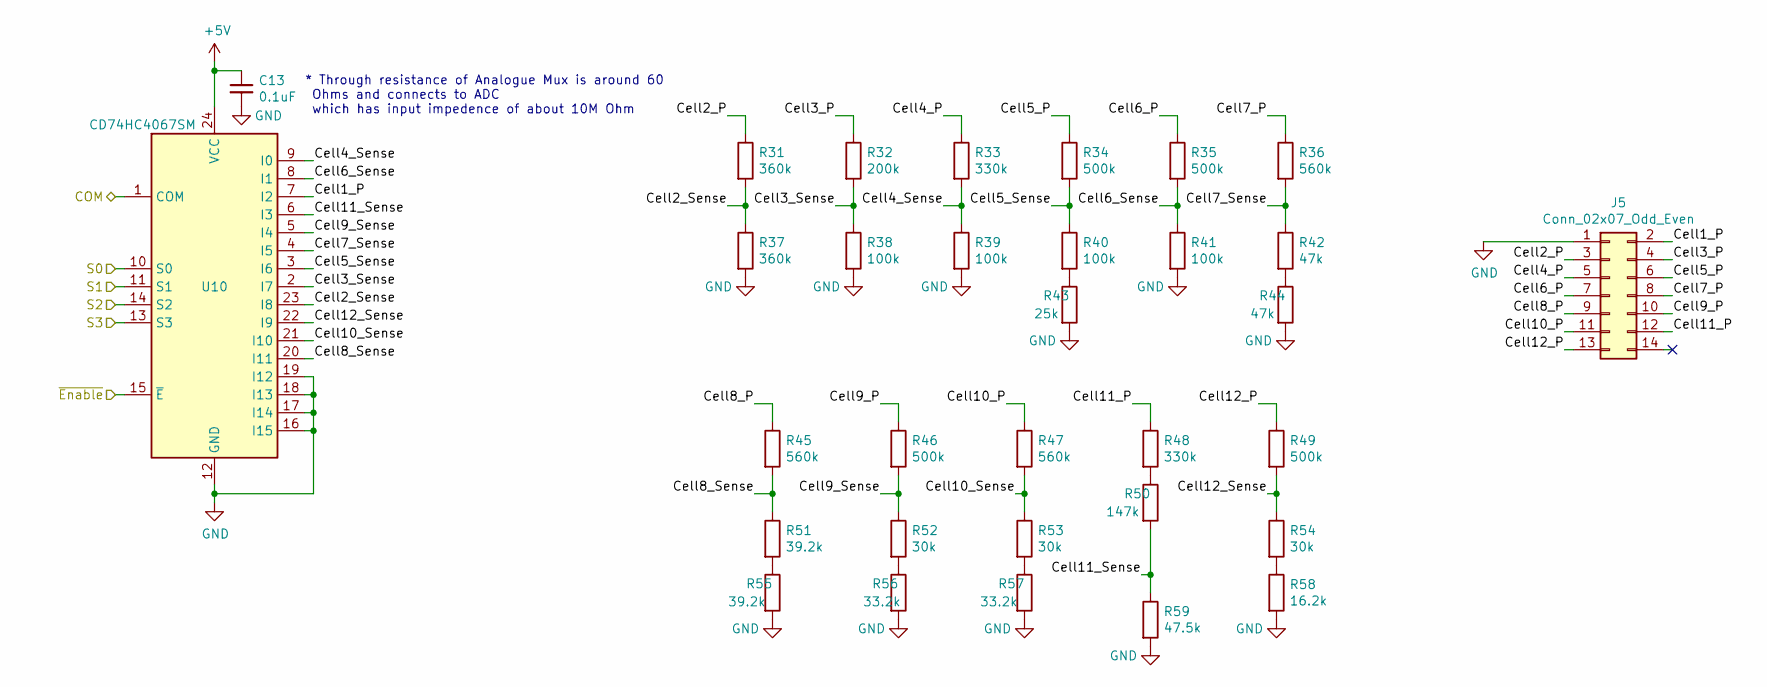
[picture p27: schematic voltmux.kicad_sch]

Parts:
C13: 0.1uF; C_0805_2012Metric; Part Number C0805C104Z4VACTU; Digikey Number 399-9159-2-ND
J5: Conn_02x07_Odd_Even; Molex_Milli_Grid_0878325623_TopBottom; Part Number 0878325623; Digikey Number WM6815TR-ND
R31, R37: 360k; R_0603_1608Metric_Pad0.98x0.95mm_HandSolder
R32: 200k; R_0603_1608Metric_Pad0.98x0.95mm_HandSolder
R33, R48: 330k; R_0603_1608Metric_Pad0.98x0.95mm_HandSolder
R34, R35, R46, R49: 500k; R_0603_1608Metric_Pad0.98x0.95mm_HandSolder
R36, R45, R47: 560k; R_0603_1608Metric_Pad0.98x0.95mm_HandSolder
R38, R39, R40, R41: 100k; R_0603_1608Metric_Pad0.98x0.95mm_HandSolder
R42, R44: 47k; R_0603_1608Metric_Pad0.98x0.95mm_HandSolder
R43: 25k; R_0603_1608Metric_Pad0.98x0.95mm_HandSolder
R50: 147k; R_0603_1608Metric_Pad0.98x0.95mm_HandSolder
R51, R55: 39.2k; R_0603_1608Metric_Pad0.98x0.95mm_HandSolder
R52, R53, R54: 30k; R_0603_1608Metric_Pad0.98x0.95mm_HandSolder
R56, R57: 33.2k; R_0603_1608Metric_Pad0.98x0.95mm_HandSolder
R58: 16.2k; R_0603_1608Metric_Pad0.98x0.95mm_HandSolder
R59: 47.5k; R_0603_1608Metric_Pad0.98x0.95mm_HandSolder
U10: CD74HC4067SM; SSOP-24_5.3x8.2mm_P0.65mm; Part Number CD74HC4067SM96; Digikey Number 296-9226-2-ND

Connections:
/S0_V: U10.10 (S0); also elsewhere on the board
/S1_V: U10.11 (S1); also elsewhere on the board
/S2_V: U10.14 (S2); also elsewhere on the board
/S3_V: U10.13 (S3); also elsewhere on the board
/VoltageMultiplex/Cell1_P: J5.2, U10.7 (I2)
/VoltageMultiplex/Cell2_P: J5.3, R31.1
/VoltageMultiplex/Cell2_Sense: R31.2, R37.1, U10.23 (I8)
/VoltageMultiplex/Cell3_P: J5.4, R32.1
/VoltageMultiplex/Cell3_Sense: R32.2, R38.1, U10.2 (I7)
/VoltageMultiplex/Cell4_P: J5.5, R33.1
/VoltageMultiplex/Cell4_Sense: R33.2, R39.1, U10.9 (I0)
/VoltageMultiplex/Cell5_P: J5.6, R34.1
/VoltageMultiplex/Cell5_Sense: R34.2, R40.1, U10.3 (I6)
/VoltageMultiplex/Cell6_P: J5.7, R35.1
/VoltageMultiplex/Cell6_Sense: R35.2, R41.1, U10.8 (I1)
/VoltageMultiplex/Cell7_P: J5.8, R36.1
/VoltageMultiplex/Cell7_Sense: R36.2, R42.1, U10.4 (I5)
/VoltageMultiplex/Cell8_P: J5.9, R45.1
/VoltageMultiplex/Cell8_Sense: R45.2, R51.1, U10.20 (I11)
/VoltageMultiplex/Cell9_P: J5.10, R46.1
/VoltageMultiplex/Cell9_Sense: R46.2, R52.1, U10.5 (I4)
/VoltageMultiplex/Cell10_P: J5.11, R47.1
/VoltageMultiplex/Cell10_Sense: R47.2, R53.1, U10.21 (I10)
/VoltageMultiplex/Cell11_P: J5.12, R48.1
/VoltageMultiplex/Cell11_Sense: R50.2, R59.1, U10.6 (I3)
/VoltageMultiplex/Cell12_P: J5.13, R49.1
/VoltageMultiplex/Cell12_Sense: R49.2, R54.1, U10.22 (I9)
/VoltageSense: U10.1 (COM); also elsewhere on the board
unnamed: R40.2, R43.1
unnamed: R42.2, R44.1
unnamed: R48.2, R50.1
unnamed: R51.2, R55.1
unnamed: R52.2, R56.1
unnamed: R53.2, R57.1
unnamed: R54.2, R58.1

Notes on the sheet:
* Through resistance of Analogue Mux is around 60 Ohms and connects to ADC which has input impedence of about 10M Ohm

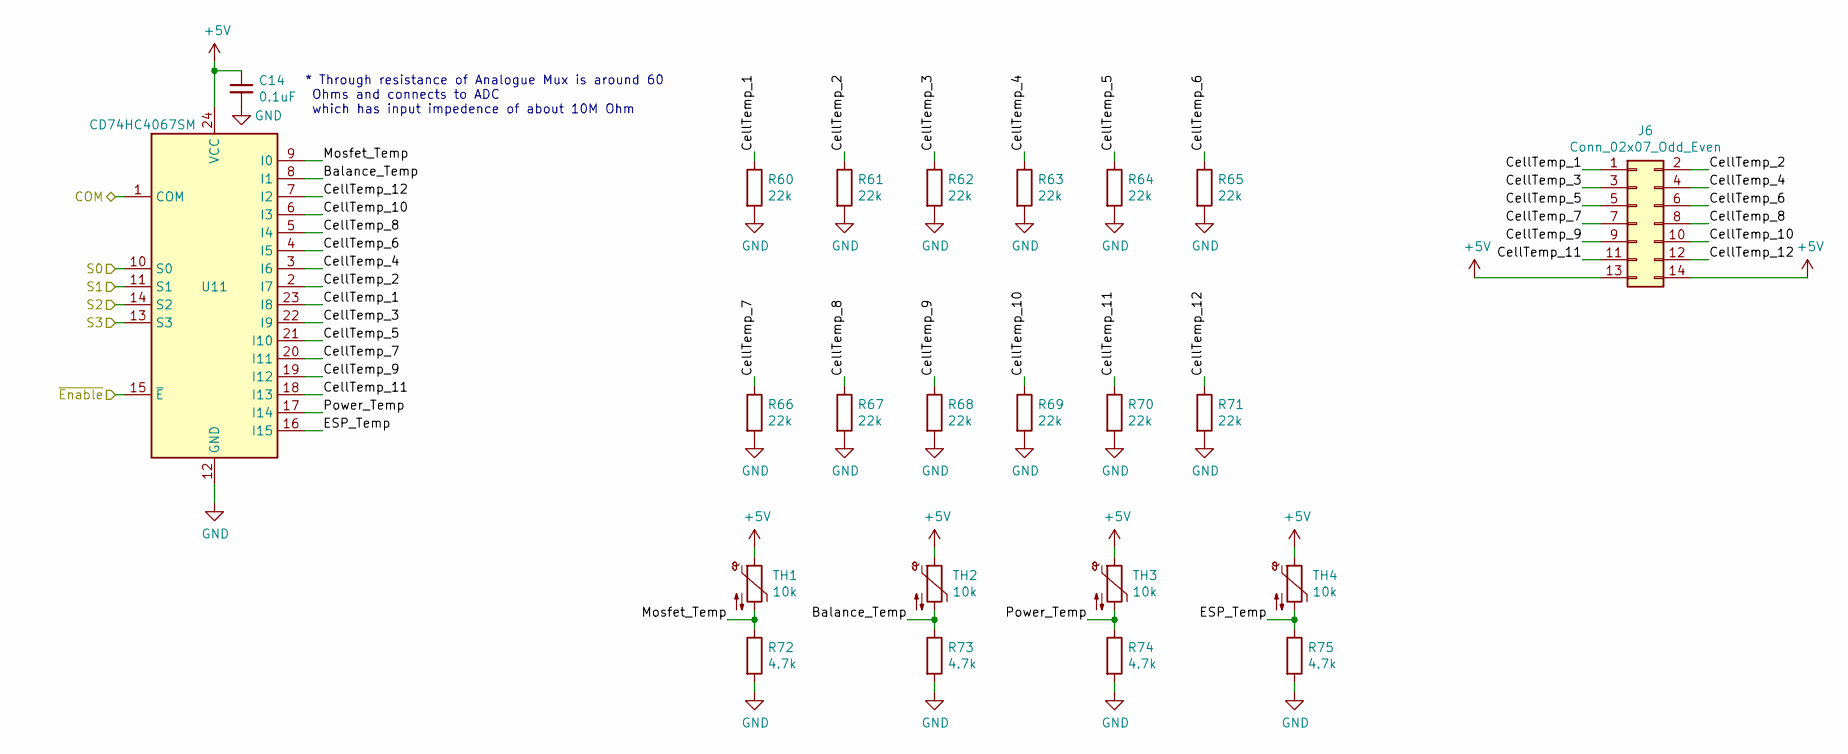
[picture p28: schematic tempmux.kicad_sch]

Parts:
C14: 0.1uF; C_0805_2012Metric; Part Number C0805C104Z4VACTU; Digikey Number 399-9159-2-ND
J6: Conn_02x07_Odd_Even; Molex_Milli_Grid_0878325623_TopBottom; Part Number 0878325623; Digikey Number WM6815TR-ND
R60, R61, R62, R63, R64, R65, R66, R67, R68, R69, R70, R71: 22k; R_0603_1608Metric_Pad0.98x0.95mm_HandSolder
R72, R73, R74, R75: 4.7k; R_0603_1608Metric_Pad0.98x0.95mm_HandSolder
TH1, TH2, TH3, TH4: 10k; R_0201_0603Metric
U11: CD74HC4067SM; SSOP-24_5.3x8.2mm_P0.65mm; Part Number CD74HC4067SM96; Digikey Number 296-9226-2-ND

Connections:
/S0_T: U11.10 (S0); also elsewhere on the board
/S1_T: U11.11 (S1); also elsewhere on the board
/S2_T: U11.14 (S2); also elsewhere on the board
/S3_T: U11.13 (S3); also elsewhere on the board
/TempMultiplex/Balance_Temp: R73.1, TH2.2, U11.8 (I1)
/TempMultiplex/CellTemp_1: J6.1, R60.1, U11.23 (I8)
/TempMultiplex/CellTemp_2: J6.2, R61.1, U11.2 (I7)
/TempMultiplex/CellTemp_3: J6.3, R62.1, U11.22 (I9)
/TempMultiplex/CellTemp_4: J6.4, R63.1, U11.3 (I6)
/TempMultiplex/CellTemp_5: J6.5, R64.1, U11.21 (I10)
/TempMultiplex/CellTemp_6: J6.6, R65.1, U11.4 (I5)
/TempMultiplex/CellTemp_7: J6.7, R66.1, U11.20 (I11)
/TempMultiplex/CellTemp_8: J6.8, R67.1, U11.5 (I4)
/TempMultiplex/CellTemp_9: J6.9, R68.1, U11.19 (I12)
/TempMultiplex/CellTemp_10: J6.10, R69.1, U11.6 (I3)
/TempMultiplex/CellTemp_11: J6.11, R70.1, U11.18 (I13)
/TempMultiplex/CellTemp_12: J6.12, R71.1, U11.7 (I2)
/TempMultiplex/ESP_Temp: R75.1, TH4.2, U11.16 (I15)
/TempMultiplex/Mosfet_Temp: R72.1, TH1.2, U11.9 (I0)
/TempMultiplex/Power_Temp: R74.1, TH3.2, U11.17 (I14)
/TempSense: U11.1 (COM); also elsewhere on the board

Notes on the sheet:
* Through resistance of Analogue Mux is around 60 Ohms and connects to ADC which has input impedence of about 10M Ohm

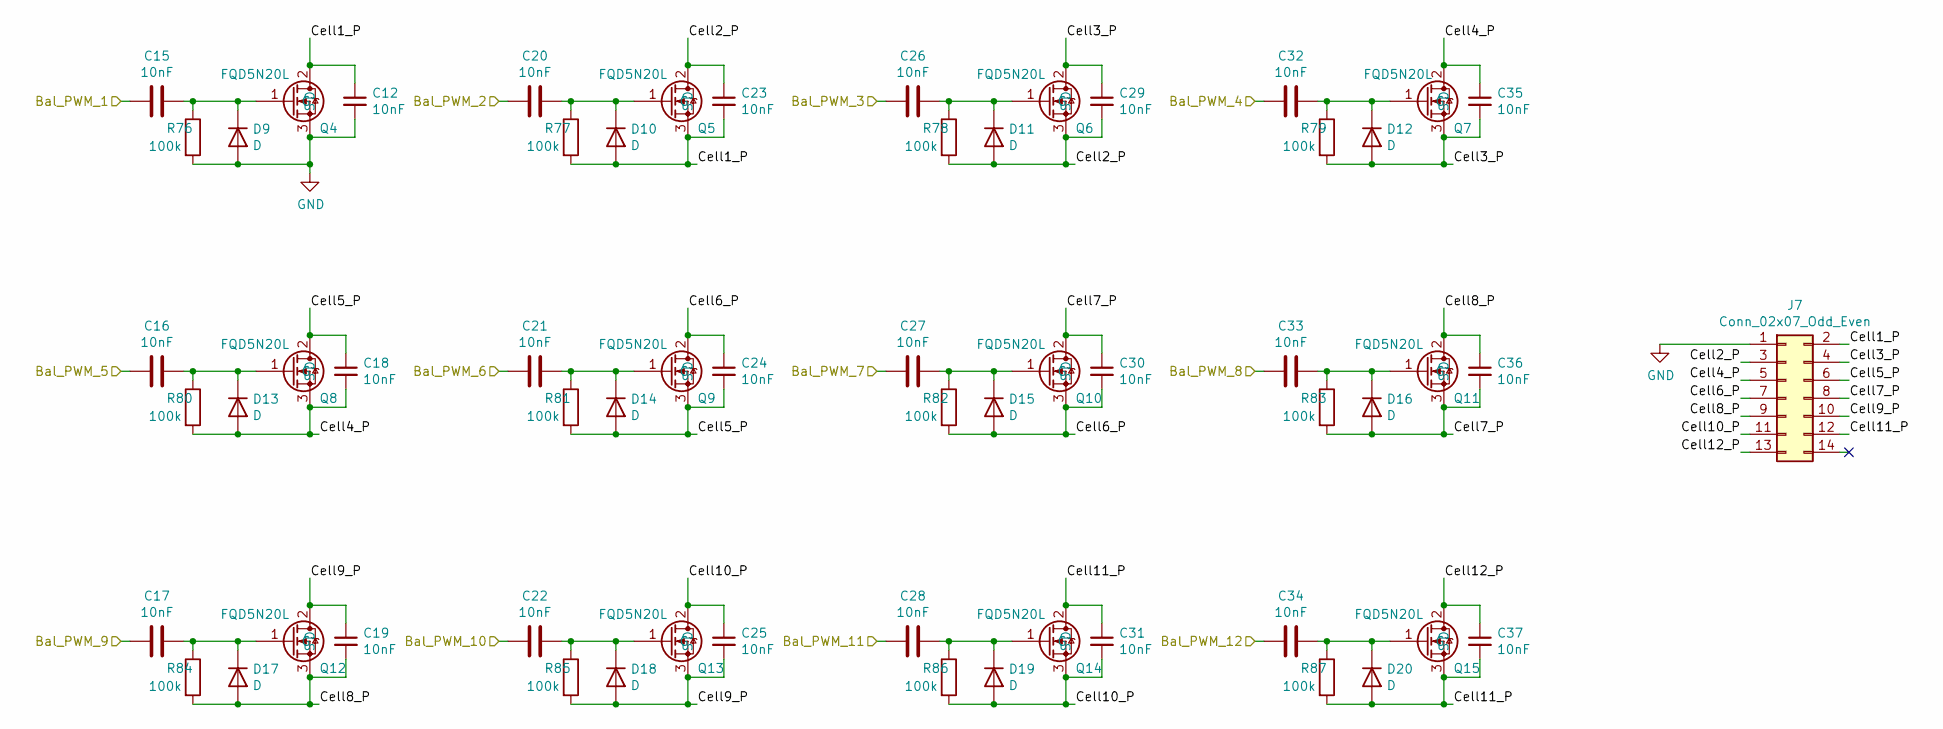
[picture p29: schematic BatteryBalance.kicad_sch]

Parts:
C12, C15, C16, C17, C18, C19, C20, C21, C22, C23, C24, C25, C26, C27, C28, C29, C30, C31, C32, C33, C34, C35, C36, C37: 10nF; C_0805_2012Metric; Part Number C0805C103J5RAC7210; Digikey Number 399-17616-2-ND
D9, D10, D11, D12, D13, D14, D15, D16, D17, D18, D19, D20: D; D_0603_1608Metric_Pad1.05x0.95mm_HandSolder
J7: Conn_02x07_Odd_Even; Molex_Milli_Grid_0878325623_TopBottom; Part Number 0878325623; Digikey Number WM6815TR-ND
Q4, Q5, Q6, Q7, Q8, Q9, Q10, Q11, Q12, Q13, Q14, Q15: FQD5N20L; TO-252-2; Part Number FQD5N20LTM; Digikey Number FQD5N20LTMTR-ND
R76, R77, R78, R79, R80, R81, R82, R83, R84, R85, R86, R87: 100k; R_0603_1608Metric_Pad0.98x0.95mm_HandSolder

Connections:
/BatteryBalance/Cell1_P: C12.1, C23.2, D10.2 (A), J7.2, Q4.2 (D), Q5.3 (S), R77.2
/BatteryBalance/Cell2_P: C23.1, C29.2, D11.2 (A), J7.3, Q5.2 (D), Q6.3 (S), R78.2
/BatteryBalance/Cell3_P: C29.1, C35.2, D12.2 (A), J7.4, Q6.2 (D), Q7.3 (S), R79.2
/BatteryBalance/Cell4_P: C18.2, C35.1, D13.2 (A), J7.5, Q7.2 (D), Q8.3 (S), R80.2
/BatteryBalance/Cell5_P: C18.1, C24.2, D14.2 (A), J7.6, Q8.2 (D), Q9.3 (S), R81.2
/BatteryBalance/Cell6_P: C24.1, C30.2, D15.2 (A), J7.7, Q9.2 (D), Q10.3 (S), R82.2
/BatteryBalance/Cell7_P: C30.1, C36.2, D16.2 (A), J7.8, Q10.2 (D), Q11.3 (S), R83.2
/BatteryBalance/Cell8_P: C19.2, C36.1, D17.2 (A), J7.9, Q11.2 (D), Q12.3 (S), R84.2
/BatteryBalance/Cell9_P: C19.1, C25.2, D18.2 (A), J7.10, Q12.2 (D), Q13.3 (S), R85.2
/BatteryBalance/Cell10_P: C25.1, C31.2, D19.2 (A), J7.11, Q13.2 (D), Q14.3 (S), R86.2
/BatteryBalance/Cell11_P: C31.1, C37.2, D20.2 (A), J7.12, Q14.2 (D), Q15.3 (S), R87.2
/BatteryBalance/Cell12_P: C37.1, J7.13, Q15.2 (D)
/PWM_Blnce_1: C15.2; also elsewhere on the board
/PWM_Blnce_2: C20.2; also elsewhere on the board
/PWM_Blnce_3: C26.2; also elsewhere on the board
/PWM_Blnce_4: C32.2; also elsewhere on the board
/PWM_Blnce_5: C16.2; also elsewhere on the board
/PWM_Blnce_6: C21.2; also elsewhere on the board
/PWM_Blnce_7: C27.2; also elsewhere on the board
/PWM_Blnce_8: C33.2; also elsewhere on the board
/PWM_Blnce_9: C17.2; also elsewhere on the board
/PWM_Blnce_10: C22.2; also elsewhere on the board
/PWM_Blnce_11: C28.2; also elsewhere on the board
/PWM_Blnce_12: C34.2; also elsewhere on the board
unnamed: C15.1, D9.1 (K), Q4.1 (G), R76.1
unnamed: C16.1, D13.1 (K), Q8.1 (G), R80.1
unnamed: C17.1, D17.1 (K), Q12.1 (G), R84.1
unnamed: C20.1, D10.1 (K), Q5.1 (G), R77.1
unnamed: C21.1, D14.1 (K), Q9.1 (G), R81.1
unnamed: C22.1, D18.1 (K), Q13.1 (G), R85.1
unnamed: C26.1, D11.1 (K), Q6.1 (G), R78.1
unnamed: C27.1, D15.1 (K), Q10.1 (G), R82.1
unnamed: C28.1, D19.1 (K), Q14.1 (G), R86.1
unnamed: C32.1, D12.1 (K), Q7.1 (G), R79.1
unnamed: C33.1, D16.1 (K), Q11.1 (G), R83.1
unnamed: C34.1, D20.1 (K), Q15.1 (G), R87.1

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
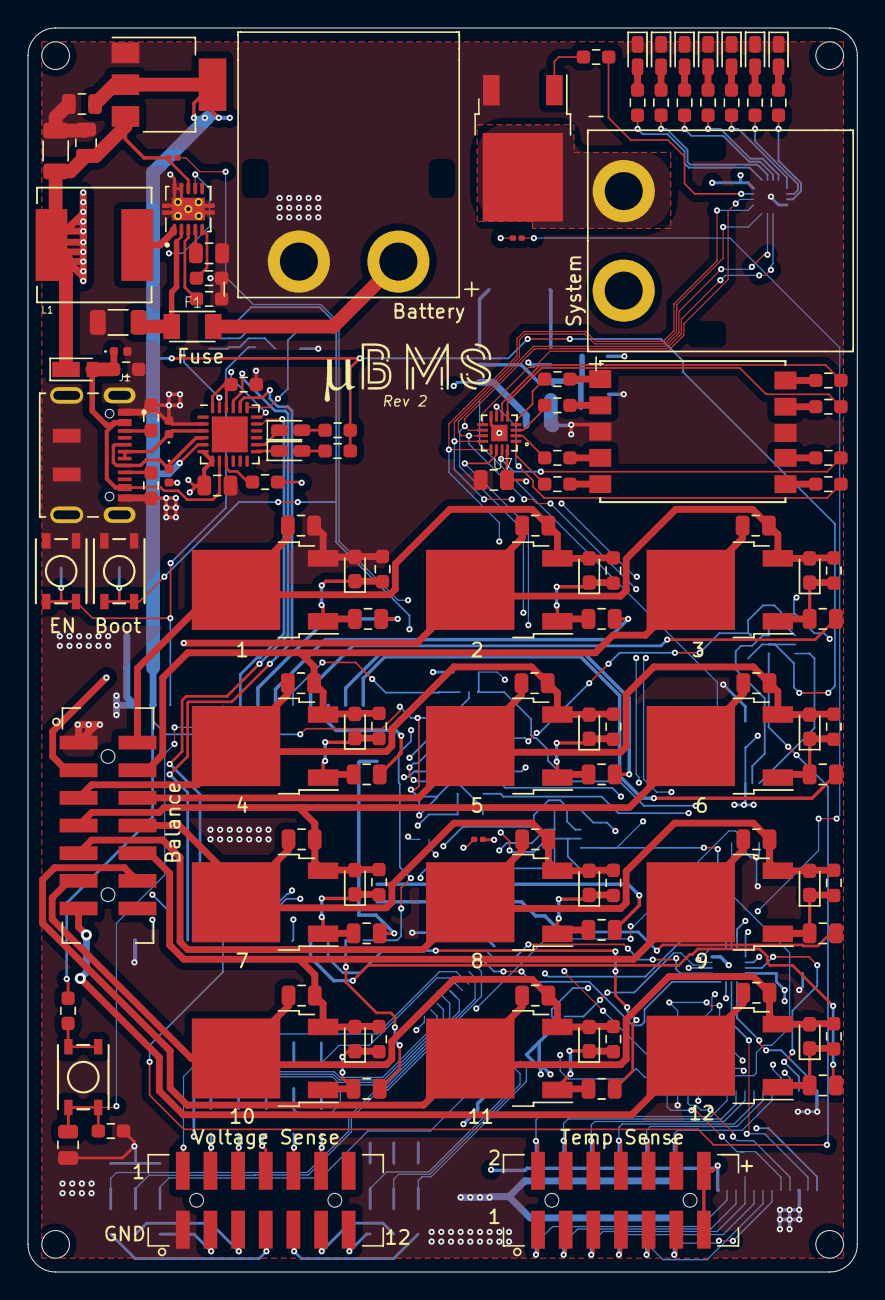
[picture p30: board uBMS-2.kicad_pcb from above]

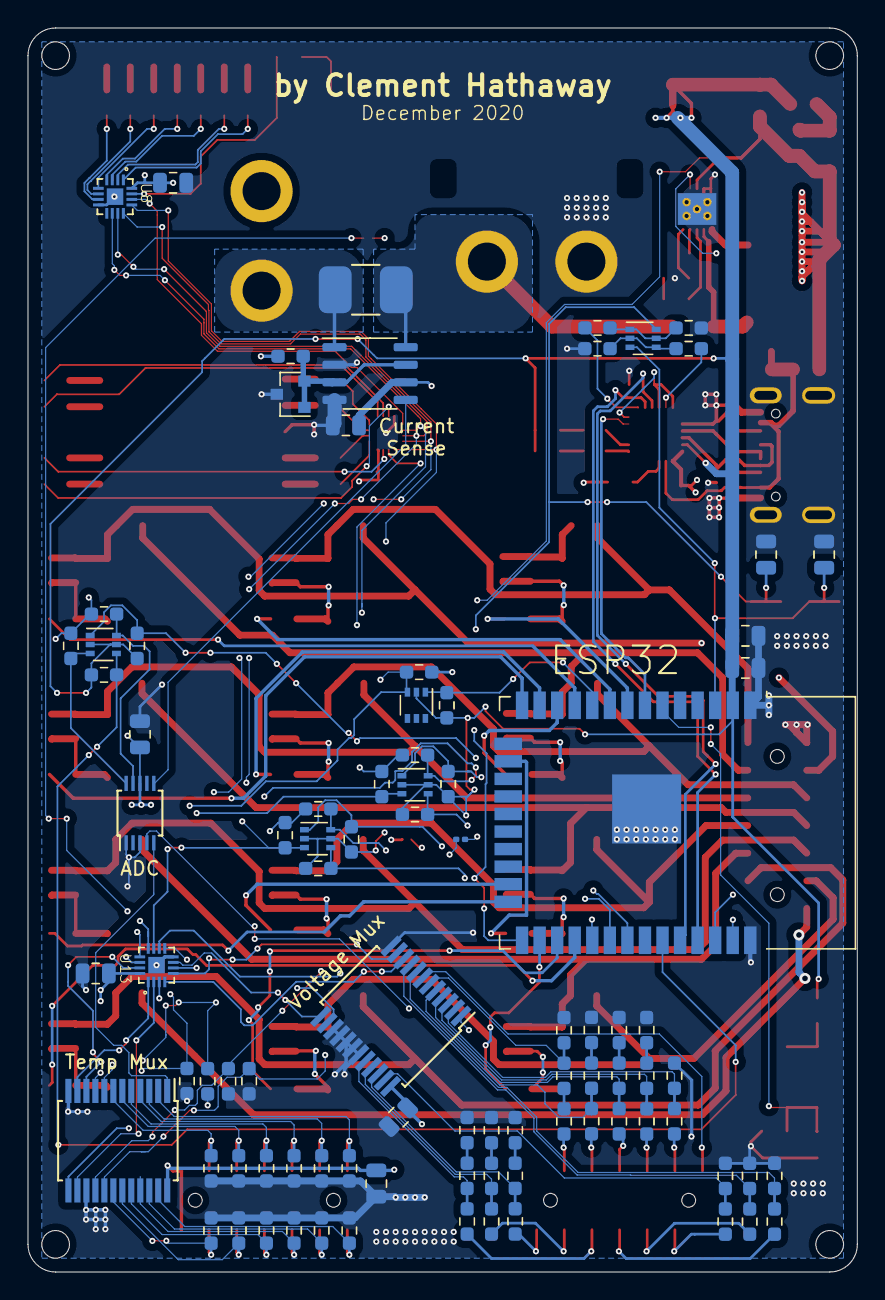
[picture p31: board uBMS-2.kicad_pcb from below]

Board: 4 copper layers, 60.0 x 90.0 mm, 221 parts (89 on the bottom side), 175 nets.
