CwbhX/uBMS-2/(commit log)

2020-06-27 Initial Files
    [uBMS-2.kicad_pcb, uBMS-2.sch]
2020-07-25 Added first component!
    ESP32 Wroom module with PS circuitry
    [uBMS-2.sch]
2020-07-26 Added Programming & Reset Buttons
    Using info from:
    - https://esp32.com/viewtopic.php?f=2&t=10442
    - https://github.com/espressif/esptool/wiki/ESP32-Boot-Mode-Selection
    - https://www.espressif.com/sites/default/files/documentation/esp32-wroom-32_datasheet_en.pdf
    [uBMS-2.sch]
2020-07-26 Added Buck Converter SMPS
    [uBMS-2.sch]
2020-07-26 Added ADC Section
    [uBMS-2.sch]
2020-07-26 Added I2C Level Shifter
    - Also connected I2C pins on ESP32
    [uBMS-2.sch]
2020-07-27 Added Linear Voltage Regulator
    [uBMS-2.sch]
2020-07-27 Added PWM Balance Ports on ESP
    - Runs in counterclock wise order around the chiplet with the antenna facing up
    - Avoiding using GPIO0 since it is a boot pin
    - Avoiding using DAC_1 incase I need to use it later
    [uBMS-2.sch]
2020-07-27 Added current sense
    - Had to change the design to place the current sense amp after the module disconnect switch to prevent destruction of the amp
    [uBMS-2.sch]
2020-07-27 Added current sense label
    [uBMS-2.sch]
2020-07-27 Added Module Disconnect
    [uBMS-2.sch]
2020-07-27 Added GPIO expander
    [uBMS-2.sch]
2020-07-27 Fixed current sense
    [uBMS-2.sch]
2020-07-27 Added 7 Seg & RGB Indicators
    [uBMS-2.sch]
2020-07-27 Added battery indicator LEDs
    [uBMS-2.sch]
2020-07-28 Added Mux Sheets
    [tempmux.sch, uBMS-2.sch, voltmux.sch]
2020-07-29 Updated Current Sense Section + Added Fuse for PS
    [tempmux.sch, uBMS-2.sch, voltmux.sch]
2020-07-29 Added pins to Hierarchical Sheets
    [uBMS-2.sch, voltmux.sch]
2020-07-29 Work on Voltage Sheet
    [tempmux.sch, uBMS-2.sch, voltmux.sch]
2020-07-29 Finished Voltage divider network
    [voltmux.sch]
2020-07-29 Finished voltage sense sheet
    [uBMS-2.sch, voltmux.sch]
2020-07-29 Finished Temp Sheet
    [tempmux.sch, uBMS-2.sch]
2020-07-29 Wired up second GPIO expander and reset pins
    [uBMS-2.sch]
2020-07-30 Finished Balance Sheet
    [BatteryBalance.sch, tempmux.sch, uBMS-2.sch, voltmux.sch]
2020-07-30 Connected Balance Sheet
    [uBMS-2.sch]
2020-07-30 Think I just added labels?
    [BatteryBalance.sch, tempmux.sch, uBMS-2.sch, voltmux.sch]
2020-07-30 Added Micro SD Card Interface
    [uBMS-2.sch]
2020-07-30 Fixed pull up for enable pin on GPIO
    [uBMS-2.sch]
2020-07-30 Added buttons + redid numbering
    [BatteryBalance.sch, tempmux.sch, uBMS-2.sch, voltmux.sch]
2020-08-01 Added PCB temp sensors and redit numberings
    [tempmux.sch, uBMS-2.sch]
2020-08-02 Added most footprints
    [BatteryBalance.sch, tempmux.sch, uBMS-2.sch, voltmux.sch]
2020-08-02 added card detect sd card stuff
    [uBMS-2.sch]
2020-08-03 Switched to lower GPIO pin part to save space
    [BatteryBalance.sch, tempmux.sch, uBMS-2.sch, voltmux.sch]
2020-08-03 Created 7-seg footprint (local)
    [uBMS-2.sch]
2020-08-03 Updated SD card adapter, again, for MEM2061
    [uBMS-2.sch]
2020-08-03 Removed SD card Adapter, added programming port
    [BatteryBalance.sch, tempmux.sch, uBMS-2.sch, voltmux.sch]
2020-08-03 Added more power connectors
    [uBMS-2.sch]
2020-08-03 Added ext ADC pin and fixed connection bugs
    [BatteryBalance.sch, tempmux.sch, uBMS-2.sch, voltmux.sch]
2020-08-03 Added JST power connect and fixed some footprints
    [BatteryBalance.sch, S2B-PH-SM4-TB(LF)(SN)--3DModel-STEP-56544.STEP, tempmux.sch, uBMS-2.sch, voltmux.sch]
2020-08-03 Redid programming port for 2x3 config
    [uBMS-2.sch]
2020-08-03 Removed additional power connector
    [uBMS-2.sch]
2020-08-03 Refactored some naming
    [BatteryBalance.sch, tempmux.sch, uBMS-2.sch, voltmux.sch]
2020-08-03 added main power connector
    [uBMS-2.sch]
2020-08-03 Added new 14 pin connector footprint
    [tempmux.sch, voltmux.sch]
2020-08-03 Updated balance connector
    [BatteryBalance.sch]
2020-08-04 Replaced Shunt resistor with normal resistor schematic symbol
    [uBMS-2.kicad_pcb, uBMS-2.sch]
2020-08-05 Using Molex Milli Grid Connector for 14 pin
    [878325623.stp, BatteryBalance.sch, tempmux.sch, uBMS-2.kicad_pcb, voltmux.sch]
2020-08-05 Fixed power connector footprint and 3d
    [1720430202.stp, CDRH127_470M.step, Connector_1720430202.step, DR125 series.stp, PTS636SM43SMTRLFS.stp, uBMS-2.kicad_pcb, uBMS-2.sch]
2020-08-05 Laid out Balance Circuitry
    [PLCC6-LED.step, RES2512.stp, SO8 Narrow 3.9mm.step, uBMS-2.kicad_pcb]
2020-08-05 Added rounded corners and 2mm mounting holes
    [uBMS-2.kicad_pcb, uBMS-2.sch]
2020-08-06 Laid out components on PCB in semi-final state
    [uBMS-2.kicad_pcb, uBMS-2.sch]
2020-08-06 Fixed volt reg footprint, fill power planes, added high current paths
    [uBMS-2.kicad_pcb, uBMS-2.sch]
2020-08-07 routed and filled a bunch of stuff, so much more to do
    [BatteryBalance.sch, tempmux.sch, uBMS-2.kicad_pcb, uBMS-2.sch, voltmux.sch]
2020-08-08 Routed a LOT more PCB traces
    [uBMS-2.kicad_pcb, uBMS-2.sch]
2020-08-08 Everything is finally routed
    [uBMS-2.kicad_pcb]
2020-08-08 Fixed connections
    [uBMS-2.kicad_pcb]
2020-08-09 Added Name and Logo
    [uBMS-2.kicad_pcb]
2020-08-09 Generated Gerbers for JLCPCB
    [uBMS-2-B_Cu.gbr, uBMS-2-B_Mask.gbr, uBMS-2-B_SilkS.gbr, uBMS-2-Edge_Cuts.gbr, uBMS-2-F_Cu.gbr, uBMS-2-F_Mask.gbr, uBMS-2-F_SilkS.gbr, uBMS-2-In1_Cu.gbr]
2020-08-12 Created 3D model and BOM with priliminary pricing
    [uBMS-2 BOM.xlsx, uBMS-2.step]
2020-11-22 Fixed Vcc issue on MCP23008 to prevent shorting in schematic (NOT PCB)
    - Still need to add caps to the balance section
    - Update PCB
    [uBMS-2.sch]
2020-11-27 Voltage Reg and PTC replacement and balance fet DS caps SCHEMATIC ONLY
    - Also added new fields to some of the new parts to make a more complete schematic, I'll slowly be adding this to the other components
    - Hopefully the new DC-DC has a MUCH smaller footprint
    - Need to fix ESP32 boot issue still
    - Need to prepare SMD XT60 Connectors
    - Need to remove RGB
    - Need to reduce brightness of status LEDs
    - Larger NTCs?
    - Need to find parts for newly added passives + footprints
    - Eventually update the PCB (ah im scared)
    - New parts will be going in my ClementsComponents Repo
    [BatteryBalance.sch, tempmux.sch, uBMS-2.sch, voltmux.sch]
2020-11-29 USB to UART & USB-C & Resized sheet to A3 & Parts List Markdown
    - Added Automatic programming circuitry with MOSFETs
    - Removed Button 2
    - Todo: Add Protection Diodes USB lines
    - Todo: Check if VBUS input to UART controller is 5v tolerant
    [uBMS-2.sch]
2020-11-30 Annotated new symbols & Changed Buck Inductor and Freq & Added USB protection diodes
    - L1 is now 100uH rated for 1.1A
    - Switching freq is now 400kHz
    - Need to find proper specced input and output caps
    - Does VBus need 3.3v or 5v input?
    - R23 is now 71.5k
    [BatteryBalance.sch, uBMS-2.sch]
2020-12-01 Added XT-60 connector for power input and output on schematic
    [uBMS-2.sch]
2020-12-01 Footprint and data maintence... and a couple values
    - PTC 300mA Fuse
    - TVS Diodes now have footprints and data
    - Red and Green USB Transmit LEDs now have footprints & data
    - Power Schottkey Diode from USB-C footprint n data
    - CP2102N-A02-GQFN24 footprint n data
    - Replaced old 2N7002 with the digikey variant with more data
    - Shunt resistor with DATA
    - Updated Battery indicator resistors to 470 ohm from 270ohm
    - Updated battery indicator leds to same as transmit leds for usb c
    [uBMS-2.sch]
2020-12-02 Added missing annotations & added USB-C Connector
    - Using KiCAD symbol for USB-C Connector but using proper footprint, I think pins should match up
    [uBMS-2.sch]
2020-12-02 Updated all the caps (I think) mostly changed to 0805
    - Added 0603 footprints to new resistors which is slightly different from the old 0603 resistors for some reason???
    - Annotated the schematic
    - Still need to do the inductor oof
    [BatteryBalance.sch, tempmux.sch, uBMS-2.sch, voltmux.sch]
2020-12-02 Added inductor footprint
    [uBMS-2.sch]
2020-12-03 Added Boot and Reset Switches
    - Also added no connects to the GPIO where the RGB led used to be connected
    - Changed buttons to a smaller button
    [uBMS-2.sch]
2020-12-03 Fixed footprint name issue for button
    [uBMS-2.sch]
2020-12-03 Organised the schematic
    [uBMS-2.sch]
2020-12-03 Minor Update
    - Fixed button labels
    [uBMS-2.kicad_pcb, uBMS-2.sch]
2020-12-09 Reset 0604 resistors to smaller (older?) footprint size
    [BatteryBalance.sch, tempmux.sch, uBMS-2.sch, voltmux.sch]
2020-12-13 Replaced GPIO expanders with shift regs
    - Freed up unnessecary pins from the ESP by removing old UART signals
    - Started PCB layout
    - Replaced level shifter with fet arrat
    - Level shifter for shift reg inputs
    - Added more bat indicator LEDs
    [uBMS-2.kicad_pcb, uBMS-2.sch]
2020-12-13 Added Smaller 500mA PTC
    [uBMS-2.sch]
2020-12-13 Placed most components
    - Make sure nets are properly connected especially with power rails from battery
    [uBMS-2.kicad_pcb, uBMS-2.sch]
2020-12-21 Finish PCB Layout Preliminary
    - Moved around temp connections to the analogue mux to help aid layout
    - Moved around voltage sense connections too
    - Moved around LED status shift reg
    - " and the 7 seg shift reg
    - Added filled copper layers
    - Removed external ADC Input
    [tempmux.sch, uBMS-2.kicad_pcb, uBMS-2.sch, voltmux.sch]
2020-12-21 Fixed disconnects and silkscreen
    - LOGOOOOO
    [uBMS-2.kicad_pcb]
2020-12-21 Fixed DRC Errors
    [uBMS-2.kicad_pcb]
2020-12-21 Genreated Gerbers
    [uBMS-2-B_Cu.gbr, uBMS-2-B_Mask.gbr, uBMS-2-B_SilkS.gbr, uBMS-2-Edge_Cuts.gbr, uBMS-2-F_Cu.gbr, uBMS-2-F_Mask.gbr, uBMS-2-F_SilkS.gbr, uBMS-2-In1_Cu.gbr]
2020-12-21 Remvoed Status Silkscreen msg
    [uBMS-2-B_Cu.gbr, uBMS-2-B_Mask.gbr, uBMS-2-B_SilkS.gbr, uBMS-2-Edge_Cuts.gbr, uBMS-2-F_Cu.gbr, uBMS-2-F_Mask.gbr, uBMS-2-F_SilkS.gbr, uBMS-2-In1_Cu.gbr]
2020-12-21 Updated some properties and generated BOM with KiBOM
    [BatteryBalance.sch, tempmux.sch, uBMS-2 BOM.xlsx, uBMS-2.sch, voltmux.sch]
2020-12-22 Added more part info
    - also updated BOM
    [tempmux.sch, uBMS-2.sch, voltmux.sch]
2021-01-20 Updated voltage issues for CP2102
    - Hopefully this fixes the murdering of this chip and it then shorting my 3v3 rail to 5v
    [uBMS-2.sch]
2021-01-20 Updated voltage divider values
    - Also changed top R1 to R22 to match previous R22 that was there (try to retain pad layout)
    [uBMS-2.sch]
2022-03-06 Update to KiCAD 6 files
    [BatteryBalance.kicad_sch, tempmux.kicad_sch, uBMS-2.kicad_pcb, uBMS-2.kicad_sch, voltmux.kicad_sch]
