CwbhX/uBMS-2/(notices)

Notices in the files:
3D Models/PTS636SM43SMTRLFS.stp:
FILE_NAME( 'p:/temp/worker_114/temp/exporttempdir_2824_280_GOOnw/format_0/PTS636SM43SMTRLFS.stp', '2020-07-31T11:05:10', ( 'License CC BY-ND 4.0' ), ( 'CADENAS' ), ' ', 'PARTsolutions', ' ' );
parts and their libraries:
Copyright 2016 Accelerated Designs. All rights reserved.
